elhep/FMC_SDR/IMG/render.png

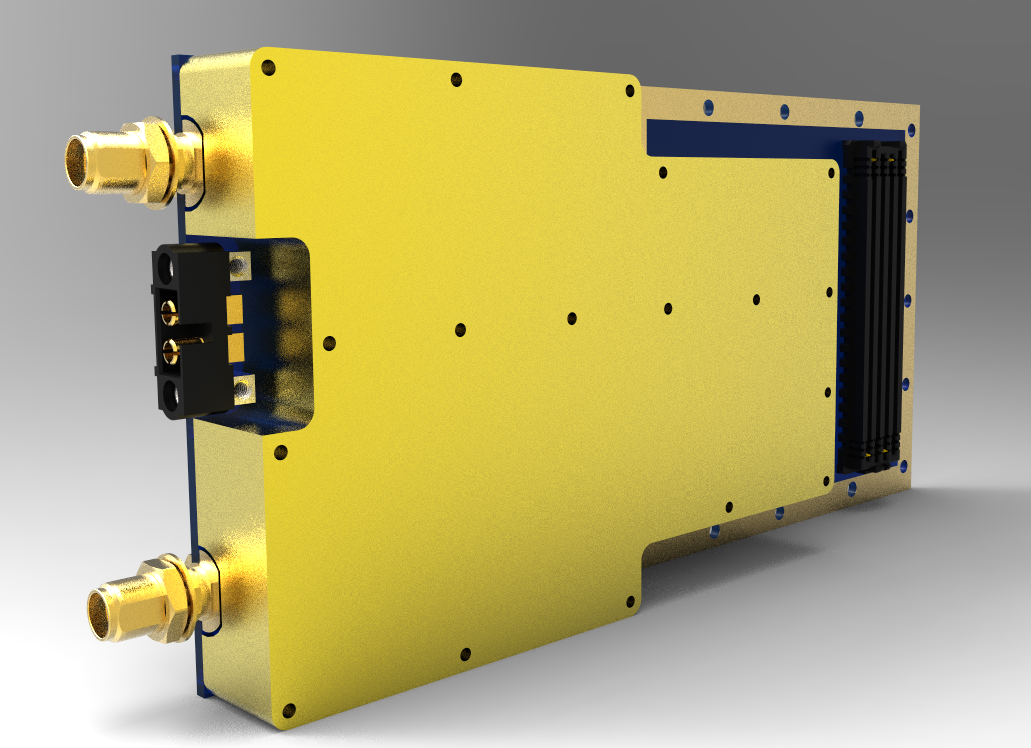
IMG/render.png
