elhep/FMC_SDR/FMC_SDR_LFFE/FMC_SDR_LFFE/31850-200.png

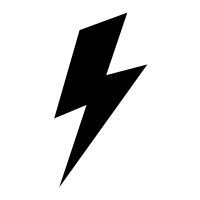
FMC_SDR_LFFE/FMC_SDR_LFFE/31850-200.png
