elhep/FMC_SDR/FMC_SDR/FMC_SDR/Project Outputs for FMC_SDR/BOM/Bill of Materials-FMC_SDR.xls

Author | Manufacturer | Manufacturer Part Number | Manufacturer_Part_Number | Comment | Description | Designator | Footprint | Quantity
CERN DEM JMW |  |  |  | Plated Hole | Single Terminal Socket | B19, B23, B24, B25 | MTG270_500 | 4
 |  |  |  | 0603 Female |  | BSC1, BSC2, BSC3, BSC4, BSC5, BSC7, BSC8, BSC9, BSC10, BSC11, BSC12, BSC13, BSC14, BSC15, BSC16, BSC17, BSC20, BSC21 | PCB_CONN_0603F | 18
 |  |  |  | 1206 Female |  | BSC18, BSC19 | PCB_CONN_1206F | 2
CERN DEM JLC | GENERIC | CC0402_100NF_16V_10%_X7R |  | 100nF | Non-polarised capacitor | C1, C3, C15, C25, C29, C31, C37, C40, C42, C44, C45, C48, C49, C50, C53, C55, C56, C59, C60, C61, C62, C72, C75, C76, C77, C78 | CAPC1005X55N | 26
CERN DEM JLC | GENERIC | CC0402_1UF_16V_10%_X5R |  | 1uF | Non-polarised capacitor | C2, C11, C27, C33, C35, C36, C63, C66, C68, C70, C79, C82, C86, C88, C94, C95 | CAPC1005X55N | 16
CERN DEM JLC | GENERIC | CC0603_10uF_6.3V_20%_X5R |  | 10uF | Non-polarised capacitor | C4, C6, C28, C30, C38, C41, C57, C58, C73, C74 | CAPC1608X87N | 10
CERN DEM JLC | GENERIC | CC0402_1NF_50V_10%_X7R |  | 1nF | Non-polarised capacitor | C5, C8, C17, C19, C21, C22, C23, C84, C92, C101, C130, C133, C136, C139, C142, C145, C148, C151, C154, C160, C198, C204, C206, C208, C210, C212, C214, C215, C216, C217 | CAPC1005X55N | 30
CERN DEM JLC | GENERIC | CC0201_1NF_16V_10%_X5R |  | 1nF | Non-polarised capacitor | C7, C12 | CAPC0603X33N | 2
CERN DEM JLC | GENERIC | CC0402_100PF_50V_5%_C0G |  | 100pF | Non-polarised capacitor | C9, C13, C85, C99, C102, C125, C126, C131, C134, C137, C140, C143, C146, C149, C152, C155, C158, C199, C205, C207, C209, C211, C213 | CAPC1005X55N | 23
CERN DEM JLC | GENERIC | CC0603_1uF_16V_10%_X7R |  | 1uF | Non-polarised capacitor | C10 | CAPC1608X87N | 1
CERN DEM JLC | GENERIC | CC1206_1UF_50V_10%_X7R |  | 1uF | Non-polarised capacitor | C14, C16, C20, C132, C138, C144, C147, C150, C153, C156, C162 | CAPC3216X140N | 11
CERN DEM JLC | GENERIC | CC0603_10UF_10V_10%_X5R |  | 10uF | Non-polarised capacitor | C18 | CAPC1608X80N | 1
CERN DEM JLC | GENERIC | CC0402_10NF_16V_10%_X7R |  | 10nF | Non-polarised capacitor | C24, C32, C65, C81 | CAPC1005X55N | 4
CERN DEM JLC | GENERIC | CC0201_10NF_10V_10%_X5R |  | 10nF | Non-polarised capacitor | C26, C34, C64, C69, C71, C80, C83, C87, C89, C91, C96, C97, C98 | CAPC0603X33N | 13
CERN DEM JLC | GENERIC | CTE3216-18_2.2UF_25V_10% |  | 2.2uF | Polarised capacitor | C39, C52 | CAPMP3216X180N | 2
CERN DEM JLC | GENERIC | CC1206_47UF_25V_20%_X5R |  | 47uF | Non-polarised capacitor | C43, C46, C47 | CAPC3216X180N | 3
CERN DEM JLC | TDK | C3216JB1V226M160AC |  | 22uF | Non-polarised capacitor | C51, C54 | CAPC3216X180N | 2
CERN DEM MR | Undefined | CC0603_NO-VALUE |  | Undefined | Non-polarised capacitor | C93 | CAPC1608X90N | 1
CERN DEM JLC | ANALOG DEVICES | AD7291BCPZ |  | AD7291BCPZ | 8-Channel, I2C, 12-Bit SAR ADC with Temperature Sensor | IC1 | QFN50P400X400X80-21N-S275 | 1
CERN DEM JLC | ST MICROELECTRONICS | M24C02-RDW6TP |  | M24C02-RDW6TP | 2-Kbit (256 x 8bit) Serial I2C Bus EEPROM | IC2 | SOP65P640X120-8N | 1
CERN DEM JLC | MICROCHIP TECHNOLOGIY | MCP9801-M/MS |  | MCP9801-M/MS | 2-Wire High-Accuracy Temperature Sensor | IC3 | SOP65P490X110-8N | 1
 |  |  | ADP2164ACPZ-R7 | ADP2164ACPZ-R7 | 6.5 V, 4 A, High Efficiency,Step-Down,DC-to-DC Regulator | IC4 | CP_16_26 | 1
CERN DEM JLC | ANALOG DEVICES | AD9364BBCZ |  | AD9364BBCZ | RF 1×1 transceiver with integrated 12-bit DACs and ADCs | IC6 | BGA144C80P12X12_1000X1000X170 | 1
CERN DEM JLC | SAMTEC | ASP-134488-01 |  | VITA 57 | Connector VITA 57, 160 Male contacts in 4 row cdgh | J2 | SAMTEC_ASP-127797-01 | 1
CERN DEM JLC | MURATA | BLM15HD102SN1D |  | 1k@100MHz |  | L1 | INDC1005X55N | 1
CERN DEM JMW | COILCRAFT | 0805CS-331XGL |  | 330nH | Inductor With Core | L2, L3 | IND_COILCRAFT_0805CS | 2
CERN DEM JMW | TDK | MMZ1608B601CTAH0 |  | 600R@100MHz |  | L6 | INDC1608X75N | 1
 |  |  |  | 2.2 A, 0.47 uH | WE-MAIA SMD Power Inductor, size 2506, 2.2 A, 0.47 uH | L7, L10 | WE-MAIA_2506 | 2
CERN DEM JLC | TDK | MPZ1608R391A |  | 390R@100MHz |  | L8 | INDC1608X95N | 1
 |  |  |  | 4.7 A, 2.2 uH | WE-MAIA SMD Power Inductor, size 4020, 4.7 A, 2.2 uH | L9 | WE-MAIA_4020 | 1
GK | EPSON | X1E000021036701 |  | 40MHz | 40MHz ±10ppm Crystal 7pF 40 Ohms 4-SMD, No Lead | Q1 | XTAL_EPSON_TSX-3225 | 1
CERN DEM JLC | GENERIC | R0402_10K_1%_0.0625W_100PPM |  | 10k | Resistor - 1% | R1, R5, R6, R8, R22, R26, R29, R30, R33, R34 | RESC1005X40N | 10
CERN DEM JLC | GENERIC | R0402_49R9_1%_0.0625W_100PPM |  | 49R9 | Resistor - 1% | R2, R11, R36 | RESC1005X40N | 3
CERN DEM JLC | GENERIC | R0402_100K_1%_0.0625W_100PPM |  | 100k | Resistor - 1% | R3, R4, R15, R16, R17 | RESC1005X40N | 5
CERN DEM JLC | GENERIC | R0402_1R_1%_0.0625W_200PPM |  | 1 | Resistor - 1% | R7, R9 | RESC1005X40N | 2
CERN DEM JLC | GENERIC | R0603_14K3_0.1%_0.063W_10PPM |  | 14k3 | Resistor - 0.1% | R10 | RESC1608X55N | 1
CERN DEM JLC | GENERIC | R0402_160K_1%_0.0625W_100PPM |  | 160k | Resistor - 1% | R12, R13, R18, R19, R20 | RESC1005X40N | 5
CERN DEM JLC | GENERIC | R0603_10R_1%_0.1W_200PPM |  | 10 | Resistor - 1% | R21, R24 | RESC1608X55N | 2
CERN DEM JLC | Undefined | R0603_NO-VALUE |  | Undefined | Resistor | R23 | RESC1608X55N | 1
CERN DEM JLC | GENERIC | R0402_20K_1%_0.0625W_100PPM |  | 20k | Resistor - 1% | R25 | RESC1005X40N | 1
CERN DEM JLC | GENERIC | R0603_0R_JUMPER |  | 0 | Resistor | R27, R31 | RESC1608X55N | 2
CERN DEM JLC | GENERIC | R0402_16K_1%_0.0625W_100PPM |  | 16k | Resistor - 1% | R28, R32 | RESC1005X40N | 2
CERN DEM JLC | GENERIC | R0402_10R_1%_0.0625W_200PPM |  | 10 | Resistor - 1% | R35 | RESC1005X40N | 1
CERN DEM MR | MINI-CIRCUITS | TCM1-63AX+ |  | 1:1 | 50 Ohms 10 to 6000MHz RF Transformer | TR5, TR6 | XFMR_MINI-CIRCUITS_DB1627 | 2
 | Analog Devices |  |  | ADP1755ACPZ-R7 | 1.2 A, Low VIN, Low Dropout Linear Regulator, 1.6 to 3.6 V Vin, 0.75 to 3 V Vout, Industrial, 16-pin QFN (CP-16-4), Reel | U1, U2 | CP-16-4_L | 2
