elhep/FMC_SDR/FMC_SDR_XFE/FMC_SDR_XFE/Project Outputs for FMC_SDR_XFE/BOM/Bill of Materials-FMC_SDR_XFE.xls

Author | Manufacturer | Manufacturer Part Number | Comment | Description | Designator | Footprint | Quantity
 |  |  | 06031206 Male |  | BSC1, BSC2, BSC3, BSC4, BSC5, BSC6, BSC7, BSC8, BSC10, BSC11, BSC12, BSC13, BSC14, BSC15, BSC16, BSC17, BSC20, BSC21 | PCB_CONN_0603M | 18
 |  |  | 1206 Male |  | BSC18, BSC19 | PCB_CONN_1206M | 2
CERN DEM JLC | GENERIC | CC0402_100PF_50V_5%_C0G | 100pF | Non-polarised capacitor | C1_PreampLO_RX, C1_PreampRX1, C1_PreampRX2, C10_PreampLO_RX, C10_PreampRX1, C10_PreampRX2, C13, C43, C46, C78_PreampLO_TX, C78_PreampTX, C81_PreampLO_TX, C81_PreampTX, C82_PreampLO_TX, C82_PreampTX, C87, C88, C110, C118, C123, C131, C134, C137, C140, C143, C146, C149, C152, C155, C158, C161, C164, C167, C170, C173, C176, C179, C184, C187, C190, C194, C199, C200, C205, C207, C209, C211, C213 | CAPC1005X55N | 48
CERN DEM JLC | GENERIC | CC0402_1NF_50V_10%_X7R | 1nF | Non-polarised capacitor | C2_PreampLO_RX, C2_PreampRX1, C2_PreampRX2, C14, C22, C24, C26, C28, C29, C44, C79_PreampLO_TX, C79_PreampTX, C130, C133, C136, C139, C142, C145, C148, C151, C154, C160, C163, C166, C169, C172, C175, C178, C181, C186, C189, C193, C196, C198, C204, C206, C208, C210, C212, C214, C215, C216, C217, C218, C219 | CAPC1005X55N | 45
CERN DEM JLC | GENERIC | CC1206_10uF_25V_10%_X7R | 10uF | Non-polarised capacitor | C3_PreampLO_RX, C3_PreampRX1, C3_PreampRX2, C80_PreampLO_TX, C80_PreampTX | CAPC3216X180N | 5
CERN DEM MR | GENERIC | CC1206_2.2uF_50V_10%_X7R | 2.2uF | Non-polarised capacitor | C4, C5, C6, C7 | CAPC3216X180N | 4
CERN DEM MR | Undefined | CC0603_NO-VALUE | Undefined | Non-polarised capacitor | C8, C9 | CAPC1608X90N | 2
CERN DEM JLC, CERN DEM JMW | GENERIC | CC0603_1UF_25V_10%_X7R, CC0603_1UF_50V_10%_X5R | 1uF | Non-polarised capacitor | C11, C17, C20, C48, C72, C75, C85, C86, C182, C192 | CAPC1608X87N | 10
CERN DEM JLC | TDK | CKG57NX7S1E476M500JH | 47uF | Non-polarised capacitor | C12 | CAPC_TDK_CKG57N | 1
CERN DEM JLC | GENERIC | CC0603_10NF_50V_5%_C0G | 10nF | Non-polarised capacitor | C15, C16, C19 | CAPC1608X87N | 3
CERN DEM JLC | GENERIC | CC0805_10UF_25V_10%_X5R | 10uF | Non-polarised capacitor | C18, C21, C40_BUCK_3V8, C40_BUCK_5V5, C42, C68, C70, C73, C76, C91, C93, C183 | CAPC2012X95N | 12
CERN DEM JLC | GENERIC | CC1206_1UF_50V_10%_X7R, CC1206_1UF_25V_10%_X7R | 1uF | Non-polarised capacitor | C23, C25, C27, C51, C57, C60, C95, C98, C113, C132, C138, C144, C147, C150, C153, C156, C162, C165, C168, C171, C174, C177, C180, C185 | CAPC3216X140N | 24
CERN DEM JLC, CERN DEM MR | GENERIC | CC0402_100NF_16V_10%_X7R, CC0402_100NF_50V_10%_X7R | 100nF | Non-polarised capacitor | C30, C31, C33, C34, C111, C115, C116, C119, C121, C122, C124, C201, C202, C203 | CAPC1005X55N | 14
CERN DEM JLC | GENERIC | CC0805_10UF_10V_10%_X7R | 10uF | Non-polarised capacitor | C32, C35 | CAPC2012X135N | 2
CERN DEM MR | GENERIC | CC0402_10NF_50V_10%_X7R | 10nF | Non-polarised capacitor | C36, C47, C49, C69, C71, C74, C77 | CAPC1005X55N | 7
CERN DEM JLC | Undefined | CC0402_NO-VALUE | Undefined | Non-polarised capacitor | C37, C45 | CAPC1005X55N | 2
CERN DEM JLC | TAIYO YUDEN, GENERIC | UMK105CG100DVHF, CC0402_10PF_50V_5%_C0G | 10pF | Non-polarised capacitor | C38, C52, C54, C55, C56, C58, C59, C63, C64, C65, C112, C114, C120 | CAPC1005X55N | 13
CERN DEM JLC | GENERIC | CC0805_1UF_50V_10%_X7R | 1uF | Non-polarised capacitor | C39_BUCK_3V8, C39_BUCK_5V5, C41, C90, C92 | CAPC2012X110N | 5
CERN DEM JLC | GENERIC | CC0805_2.2UF_50V_10%_X7R | 2.2uF | Non-polarised capacitor | C50, C53 | CAPC2012X140N | 2
CERN DEM JLC | TAIYO YUDEN | UMK325AB7106KMHP | 10uF | Non-polarised capacitor | C83, C84 | CAPC3225X280N | 2
CERN DEM JLC | GENERIC | CC0805_33NF_25V_10%_X7R | 33nF | Non-polarised capacitor | C109 | CAPC2012X135N | 1
CERN DEM JLC | GENERIC | CC0805_6.8NF_50V_10%_X7R | 6.8nF | Non-polarised capacitor | C117 | CAPC2012X135N | 1
CERN DEM JLC | INFINEON | BAT165 | BAT165 | Schottky Diode | D1, D2 | SOD2512X110N | 2
CERN DEM JLC | MINI-CIRCUITS | LFCN-123+ | DC to 12000MHz | 50 Ohm DC to 12000MHz Low Pass Filter | FL1, FL2 | FIL_MINI-CIRCUITS_FV1206-4 | 2
SH based on CERN | MINI-CIRCUITS | HFCN-7150+ | 7900 to 11000 MHz | 50 Ohm 7900 to 11000 MHz Bandpass Filter | FL3 | FIL_MINI-CIRCUITS_FV1206-1 | 1
SH based on CERN | MINI-CIRCUITS | HFCN-4400+ | 5000 to 10100 MHz | 50 Ohm 5000 to 10100 MHz Bandpass Filter | FL4 | FIL_MINI-CIRCUITS_FV1206-1 | 1
CERN DEM MR | MINI-CIRCUITS | LFCN-2400+ | DC to 2400MHz | 50 Ohm DC to 2400MHz Low Pass Filter | FL5 | FIL_MINI-CIRCUITS_FV1206 | 1
CERN DEM MR | MINI-CIRCUITS | BFCN-8350+ | 8250 to 8450MHz | 50 Ohm 8250 to 8450MHz Band Pass Filter | FL6 | FIL_MINI-CIRCUITS_FV1206-4 | 1
CERN DEM JLC | MINI-CIRCUITS | LEE-39+ | LEE-39+ | Monolithic Amplifier | IC1_PreampLO_RX, IC1_PreampRX1, IC1_PreampRX2, IC23_PreampLO_TX, IC23_PreampTX | MINI-CIRCUITS_FG873 | 5
CERN DEM JLC | LINEAR TECHNOLOGY | LTM8056IY#PBF | LTM8056IY#PBF | 58VIN, 48VOUT Buck-Boost µModule Regulator | IC2 | BGA121C127P11X11_1500X1500X512 | 1
CERN DEM JLC | LINEAR TECHNOLOGY | LTM8074IY#PBF | LTM8074IY#PBF | 40VIN, 1.2A Silent Switcher µModule Regulator | IC3_BUCK_3V8, IC3_BUCK_5V5, IC13, IC24, IC25 | BGA25C65P5X5_400X400X198 | 5
CERN DEM MR | LINEAR TECHNOLOGY | LT1964ES5-BYP#TRMPBF | LT1964ES5-BYP#TRMPBF | 200mA, Low Noise, Low Dropout Negative Micropower Regulator | IC4, IC11, IC12 | SOT95P280X100-5N | 3
CERN DEM JLC | LINEAR TECHNOLOGY | LT1763CS8#PBF | LT1763CS8#PBF | 1.22V to 20V 500mA, Low Noise, LDO Adjustable Micropower Regulator | IC5, IC10, IC17, IC19 | SOIC127P600X175-8N | 4
CERN DEM JLC | MINI-CIRCUITS | SIM-153+ | SIM-153+ | Level 7 (LO Power +7 dBm) 3400 to 15000 MHz | IC6, IC7 | MINI-CIRCUITS_HV1195 | 2
CERN DEM JLC | MINI-CIRCUITS | YAT-3+ | YAT-3+ | DC to 18GHz, 2W, 50 Ohm, 4dB Attenuator | IC8, IC16 | MINI-CIRCUITS_MC1630 | 2
CERN DEM JLC | TEXAS INSTRUMENTS | CDCLVC1102PW | CDCLVC1102PW | 3.3 V and 2.5 V LVCMOS 1:2 High-Performance Clock Buffer | IC9 | SOP65P640X120-8N | 1
CERN DEM JLC | LINEAR TECHNOLOGY | LTC2851CMS8#PBF | LTC2851CMS8#PBF | 3.3V 20Mbps RS485/RS422 Transceivers | IC14, IC18 | SOP65P490X110-8N | 2
SH based on CERN | MINI-CIRCUITS | QCS-83+ | QCS-83+ | 2 Way-90° Power Splitter,50Ω 4000 to 8000 MHz | IC15 | MINI-CIRCUITS_GE0805C-1 | 1
CERN DEM JLC | QORVO | QPA2609 | QPA2609 | 7-14GHz GaAs Low Noise Amplifier | IC20 | QORVO_QPA2609 | 1
CERN DEM JLC | QORVO | TGA3042-SM | TGA3042-SM | 7-10.5GHz 4.5W GaN Power Amplifier | IC21 | QORVO_TGA3042-SM | 1
CERN DEM JLC | TEXAS INSTRUMENTS | INA105KU | INA105KU | Precision, Unity-Gain Differential Amplifier | IC22 | SOIC127P600X175-8N | 1
CERN DEM JLC | LINEAR TECHNOLOGY | LT3080EDD#PBF | LT3080EDD#PBF | Adjustable 1.1A Single Resistor Low Dropout Regulator | IC26 | SON50P300X300X80-9N-R175X248 | 1
CERN DEM JLC | TELEGARTNER | J01151A0451 | SMA |  | J1, J3 | TELEGARTNER_J01151A0451 | 2
CERN DEM JMW | ROSENBERGER | 19S103-400L5 | Coax_1Male_1Shield |  | J2, J6 | ROSENBERGER_19S103-400L5 | 2
CERN DEM JLC | HIROSE (HRS) | U.FL-R-SMT-1(10) | U.FL |  | J4, J7, J8, J9, J10, J11, J13, J14 | HIROSE_U.FL-R-SMT-1(10) | 8
 | Harwin | M80-5000000M5-02-333-00-000 | M80-5000000M5-02-333-00-000 | 2pin (2 power), THT socket with M2 jackscrews | J5 | M80-5000000M5-02-333-00-000 | 1
CERN DEM MR | SAMTEC | HW-04-15-L-S-400-150 | Header 4 | Connector 4 Male | J12 | SAMTEC_HW-04-15-L-S-400-150 | 1
CERN DEM JLC | MINI-CIRCUITS | TCCH-80+ | 0.5uH@200mA | 50 Ohms, 50 to 8200 MHz RF Choke | L1_PreampLO_RX, L1_PreampRX1, L1_PreampRX2, L4_PreampLO_TX, L4_PreampTX | IND_MINI-CIRCUITS_GU1604 | 5
CERN DEM JLC | COILCRAFT | 0402DC-15NXGRW | 15nH | Inductor With Core | L2, L3 | IND_COILCRAFT_0402DC | 2
CERN DEM MR | KYOCERA | KT7050A20000KAW33TAD | 20MHZ | Oscillator KYOCERA | OSC1 | OSC_KYOCERA_KT7050A | 1
CERN DEM JLC | BOURNS | 3223W-1-503E | 50k | Trimming Potentiometer | P1, P2, P3 | TRIM_BOURNS_3223W | 3
CERN DEM JLC | GENERIC | R0402_0R_JUMPER | 0 | Resistor | R1, R8, R9, R36, R44, R65, R66, R67, R69, R72, R107 | RESC1005X40N | 11
CERN DEM JLC | Undefined | R0402_NO-VALUE | Undefined | Resistor | R2, R3, R4, R5, R6, R7, R25, R54, R55, R64, R68, R104, R106, R116 | RESC1005X40N | 14
CERN DEM JLC | Undefined | R1206_NO-VALUE | Undefined | Resistor | R10, R38, R81, R108 | RESC3216X65N | 4
CERN DEM JLC | VISHAY | R0805_40K2_1%_0.125W_100PPM | 40k2 | Resistor - 1% | R11, R52 | RESC2012X60N | 2
CERN DEM JLC | GENERIC | R0603_0R_JUMPER | 0 | Resistor | R12, R16, R20, R26, R31, R33, R56, R61, R63, R70, R83, R88, R89, R90, R91, R92, R105, R113, R115, R117_BUCK_3V8, R117_BUCK_5V5, R118, R119, R120, R125, R132, R133, R142 | RESC1608X55N | 28
CERN DEM JLC | GENERIC | R0603_100K_0.1%_0.063W_10PPM | 100k | Resistor - 0.1% | R13 | RESC1608X55N | 1
CERN DEM JLC | GENERIC | R0603_42K2_0.1%_0.063W_10PPM | 42k2 | Resistor - 0.1% | R14 | RESC1608X55N | 1
CERN DEM JLC | GENERIC | R0603_6K19_0.1%_0.063W_10PPM | 6k19 | Resistor - 0.1% | R15 | RESC1608X55N | 1
CERN DEM JLC | Undefined | R0603_NO-VALUE | Undefined | Resistor | R17, R18, R22, R24, R27, R28, R30, R32, R35, R50, R57, R150 | RESC1608X55N | 12
CERN DEM JLC | GENERIC | R0805_62K_1%_0.125W_100PPM | 62k | Resistor - 1% | R19 | RESC2012X60N | 1
CERN DEM JLC | GENERIC | R1206_0R_JUMPER | 0 | Resistor | R21, R37, R80, R82, R95, R98, R112, R114 | RESC3216X65N | 8
CERN DEM JLC | GENERIC | R0402_10K_1%_0.0625W_100PPM | 10k | Resistor - 1% | R23, R29, R34 | RESC1005X40N | 3
CERN DEM JLC | GENERIC | R0603_68R_1%_0.1W_100PPM | 68 | Resistor - 1% | R39 | RESC1608X55N | 1
CERN DEM JLC | GENERIC | R0603_430R_1%_0.1W_100PPM | 430 | Resistor - 1% | R40 | RESC1608X55N | 1
CERN DEM JLC | GENERIC | R0402_27K_1%_0.0625W_100PPM | 27k | Resistor - 1% | R41, R43 | RESC1005X40N | 2
CERN DEM MR | GENERIC | R0402_5R1_1%_0.0625W_100PPM | 5R1 | Resistor - 1% | R42, R46, R47, R48, R49, R53 | RESC1005X40N | 6
CERN DEM JLC | GENERIC | R0402_1M_1%_0.0625W_100PPM | 1M | Resistor - 1% | R45 | RESC1005X40N | 1
CERN DEM JLC | GENERIC | R0603_18K_1%_0.1W_100PPM | 18k | Resistor - 1% | R51_BUCK_3V8, R51_BUCK_5V5, R62, R99, R101 | RESC1608X55N | 5
CERN DEM JLC | GENERIC | R0603_43R_1%_0.1W_100PPM | 43 | Resistor - 1% | R58_PreampLO_RX, R58_PreampRX1, R58_PreampRX2, R59_PreampLO_TX, R59_PreampTX | RESC1608X55N | 5
CERN DEM JLC | GENERIC | R0603_45K3_0.1%_0.063W_10PPM | 45k3 | Resistor - 0.1% | R60, R100 | RESC1608X55N | 2
CERN DEM JLC | GENERIC | R0402_49R9_1%_0.0625W_100PPM | 49R9 | Resistor - 1% | R71, R73, R74, R75 | RESC1005X40N | 4
CERN DEM JLC | GENERIC | R0603_75K_1%_0.1W_100PPM | 75k | Resistor - 1% | R76, R77 | RESC1608X55N | 2
CERN DEM JLC | GENERIC | R0603_2K7_1%_0.1W_100PPM | 2k7 | Resistor - 1% | R78 | RESC1608X55N | 1
CERN DEM JLC | GENERIC | R0603_510R_1%_0.1W_100PPM | 510 | Resistor - 1% | R79 | RESC1608X55N | 1
CERN DEM JLC | GENERIC | R0402_22K_1%_0.0625W_100PPM | 22k | Resistor - 1% | R84, R86 | RESC1005X40N | 2
CERN DEM JLC | GENERIC | R0402_12K_1%_0.0625W_100PPM | 12k | Resistor - 1% | R85, R87, R96, R97 | RESC1005X40N | 4
CERN DEM BC | GENERIC | R0402_38K3_1%_0.0625W_100PPM | 38k3 | Resistor - 1% | R93, R94 | RESC1005X40N | 2
CERN DEM MR | GENERIC | R0402_0.1R_1%_0.0625W_100PPM | 0.1 | Resistor - 1% | R102, R103 | RESC1005X40N | 2
CERN DEM JLC | GENERIC | R0603_49K9_0.1%_0.063W_10PPM | 49k9 | Resistor - 0.1% | R109 | RESC1608X55N | 1
CERN DEM JLC | GENERIC | R0603_499R_0.1%_0.063W_10PPM | 499 | Resistor - 0.1% | R110 | RESC1608X55N | 1
CERN DEM JLC | GENERIC | R0603_1K96_0.1%_0.063W_10PPM | 1k96 | Resistor - 0.1% | R111 | RESC1608X55N | 1
 |  |  | ADF5356 |  | U6 | ADF3356 | 1
