elhep/FMC_SDR/inerCover_11032020.STEP

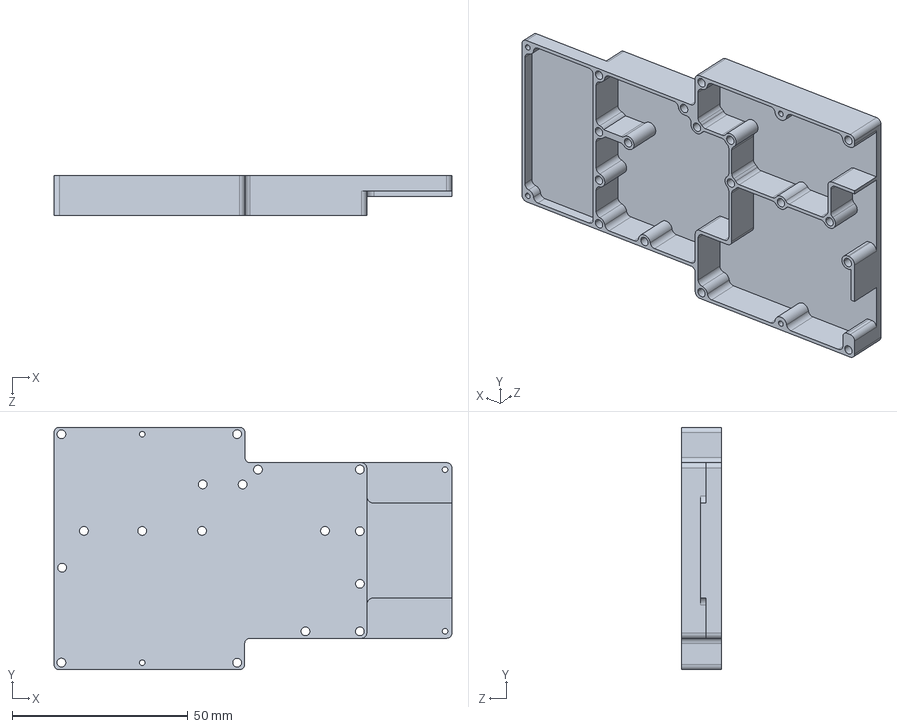
[picture p3: CAD file, 2020-03-18]
inerCover_11032020.STEP
113.3 x 69.0 x 11.5 mm
