elhep/FMC_SDR/(list of files, cad)

Other CAD files:
FMC_SDR/FMC_SDR/PCB-Layout/FMC_SDR.DWG
