elhep/FMC_SDR/(threads)

Thread 3 (2019-11-15):

X-band Rx chain

gkasprow, 2019-11-15:
Consider placing LPF filter after mixer. The LO may leak and saturate the next gain stages.

Thread 7 (2020-03-03):

DRC errors

gkasprow, 2020-03-03:
@shanasz there are some unrouted nets.
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

In case of the errors, just waive them.
Did U perform ERC and DRC?

shanasz, 2020-03-03:
I am now trying to merge new version with Your previous remarks introduced. Give me a while, I have some problem with repo.

shanasz, 2020-03-03:
But Yes, generally in tagged commits I always do ERC and DRC

gkasprow, 2020-03-03:
don't use merge function. It doesn't work with Altium files.

shanasz, 2020-03-03:
ok, design ready for review

Thread 18 (2020-03-19):

FMC_SDR IC6 AD9364

tprzywoz, 2020-03-19:
- [ ] TX/RX_EXT_LO_IN: "When this pin is unused, tie it to ground". Now they are floating (no connection on FMC_SDR_XFE board)

- [ ] RXB_P/N "Unused pins must be tied to ground". Now they are floating.

- [ ] TXB_P/N "Unused pins must be tied to 1.3 V". Now they are floating.

- [ ] There is double connection to FMC of SYNC_IN signal. Is this intentional?

- [ ] RXA / TXA to RF Transformers: For TX signal negative one is connected to Secondary Dot pin, for RX it is positive. Is this intentional? On devkit they keep negative to secondary dot connection for both.

Thread 20 (2020-03-19):

FMC_SDR 50 Ohm Impedance Profile

tprzywoz, 2020-03-19:
There is a configuration for 30 Ohm impedance on layer Int1 and Int5 instead of 50 Ohm.

tprzywoz, 2020-03-19:
And change Min Width value to Preferred Width in Width_50R rule because now some 50R traces on inner layers are 0.12 mm instead of 0.17 mm.

Thread 22 (2020-03-19):

FMC_SDR PCB rules

tprzywoz, 2020-03-19:
Clearance_50R_EXTt - there is no RF_50R ComponentClass
Clearance_50R_INT - there are no 'Int2' and 'Int3' layers
Width_BGA1 - there are no rooms at all on PCB

Thread 23 (2020-03-19):

FMC_SDR PCB review

tprzywoz, 2020-03-19:
1. Copper balance polygon shouldn't be solid plane:
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

2. Teardrops

3. Some unnecessary separations of differential pairs:
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

4. There are no fiducial markers

Thread 24 (2020-03-19):

FMC_SDR_XFE PLL

tprzywoz, 2020-03-19:
- [ ] 'Charge Pump Power Supply. Vp must have the same value as Vvco' - must be changed 3.3 V -> 5 V.

- [ ] Vregvco same as Vp

- [ ] Will we use RFOUTA? Datasheet suggests to terminate unused complementary outputs and now we can terminate only RFOUTA- by mounting C45 and there is no termination for unused RFOUT+.

- [ ] Please place capacitors on PCB according to the schematic. For example, now C112 (connected on schematic to pin 19) is connected to pin 16 on PCB. Pin 19 (Vregvco) should have more capacitors on schematics but has proper configuration on PCB (+ remember about wrong value of power supply for pin 19).

- [ ] REF_IN: R72 or R1 should be DNP

- [ ] Synchronize PLL.SchDoc block on FronEnd schematic - now REF_IN port is input type inside and output type outside.

Thread 25 (2020-03-20):

FMC_SDR_XFE IC20

tprzywoz, 2020-03-20:
- [ ] Vdd is 3.5 V (not 3.3 V, real configuration is 3.46 V) so change Power Net name.

- [ ] It is recommended to connect NC pins (5 7 13 15) to GND

Thread 26 (2020-03-20):

FMC_SDR_XFE Power Supply

tprzywoz, 2020-03-20:
IC18:
- [ ] VCC should be 3.3 V (not 5 V). And it cannot be connected to the line whose activation it potentially controls.

- [ ] check TX_NSHDN_ISO signal. Some power supply ICs have floating RUN/Enable pins which are connected only to this signal by 'Undefined' jumpers.

- [ ] detail: change net labels - TX_NSHDND_N to inverting input output (IC18 and IC14) and TX_NSHDND_P to noninverting IO.  I know it's control signal but maybe add termination resistor.

All LT1763 with 3V3 output:
- [ ] Configuration is 3,5 V, Power Port name is 3.3 V

IC17

- [ ] wrong ADJ configuration (now is 5 V)

IC26

- [ ] wrong SET configuration (now is 2.4 V, should be 20 V)

IC2

- [ ] floating RUN

- [ ] details: add some notes about configurations (RT MODE) and please connect input capacitors the same way as output on schematic.

BUCKBOOST_OUT
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

- [ ] FE_12V can't be an alternative power source for PA_LDO which output should be 20 V.

IC5:

- [ ] wrong ADJ configuration (now is 3.5 V)

IC11

- [ ] detail: double GND power port on pin 1

J5
- [ ] add a note about voltage and current

Rest:
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
I wonder if we should move the input capacitors behind the jumpers.

Please change the power names to the standard convention if possible (like P3V3_description). And don't use '-' for negative voltage. 'N' is much better. Also power symbol for positive supply should point up and those for negative supplies should point down (now most of them on FrontEnd_PS point right)

tprzywoz, 2020-03-20:
And as I wrote in the email to remember: implement bias-up/down procedure for amplifiers.

Thread 27 (2020-03-20):

Schematics cosmetics

tprzywoz, 2020-03-20:
- [ ] Use normal components instead of "undefined". Then configure them as not fitted using variant feature.

- [ ] Add 'CERN Open Hardware Licence' text

**FMC_SDR_XFE**

- [ ] Note says about FL6: "Can be exchanged for HFCN-9700+ or BFCN-5750+ for amateur bands." Add more information about other necessary component replacement because for example, BFCN-5750+ pass band is 5650 - 5850 MHz and next stage amplifier 7-14 GHz.

**FMC_SDR:**
- [ ] Place decoupling capacitors on transceiver sheet (not power supply sheet)

- [ ] fmc_connector.SchDoc - change formatting page template

- [ ] add a note about allowed Vadj levels (fmc connector)

- [ ] Maybe add some test points? I2C SPI

- [ ] We have LA33 pins free so maybe connect some diagnostic lines for example PG

Models:

- [ ] add pin type information (in/out/power) for IC4

- [ ] (XFE board) IC15 is Splitter/Combiner so 1 4 and 6 pins should be I/O. Correct the description (2 Way-90 and different frequencies)

- [ ] So-153+ correct the description

Thread 28 (2020-03-20):

New components

tprzywoz, 2020-03-20:
- [ ] **HFCN-4400+ and HFCN-7150+:**

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

- [ ] **LEE-39+**

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

- [ ] **SIM-153+** - problem with dimension K
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

- [ ] **YAT-3+** - general description 4dB, part description 3db (both should be 3dB)
- [ ] **CDCLVC1102PW** maybe add NC pins (5 & 7) to SCH.

- [ ] **QSC-83+** - problem with dimesnions H and K:
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

Thread 29 (2020-03-20):

PCB RF signals

tprzywoz, 2020-03-20:
- [ ] remember about cutouts in GND polygon under resistors and capacitors pads

- [ ] when you use two jumpers to create an alternative path, place them so that they have a common pad to reduce the impedance discontinuity
