elhep/FMC_SDR/FMC_SDR_XFE/FMC_SDR_XFE/Project Outputs for FMC_SDR_XFE/Schematic Print/FMC_SDR_XFE_SCH.PDF

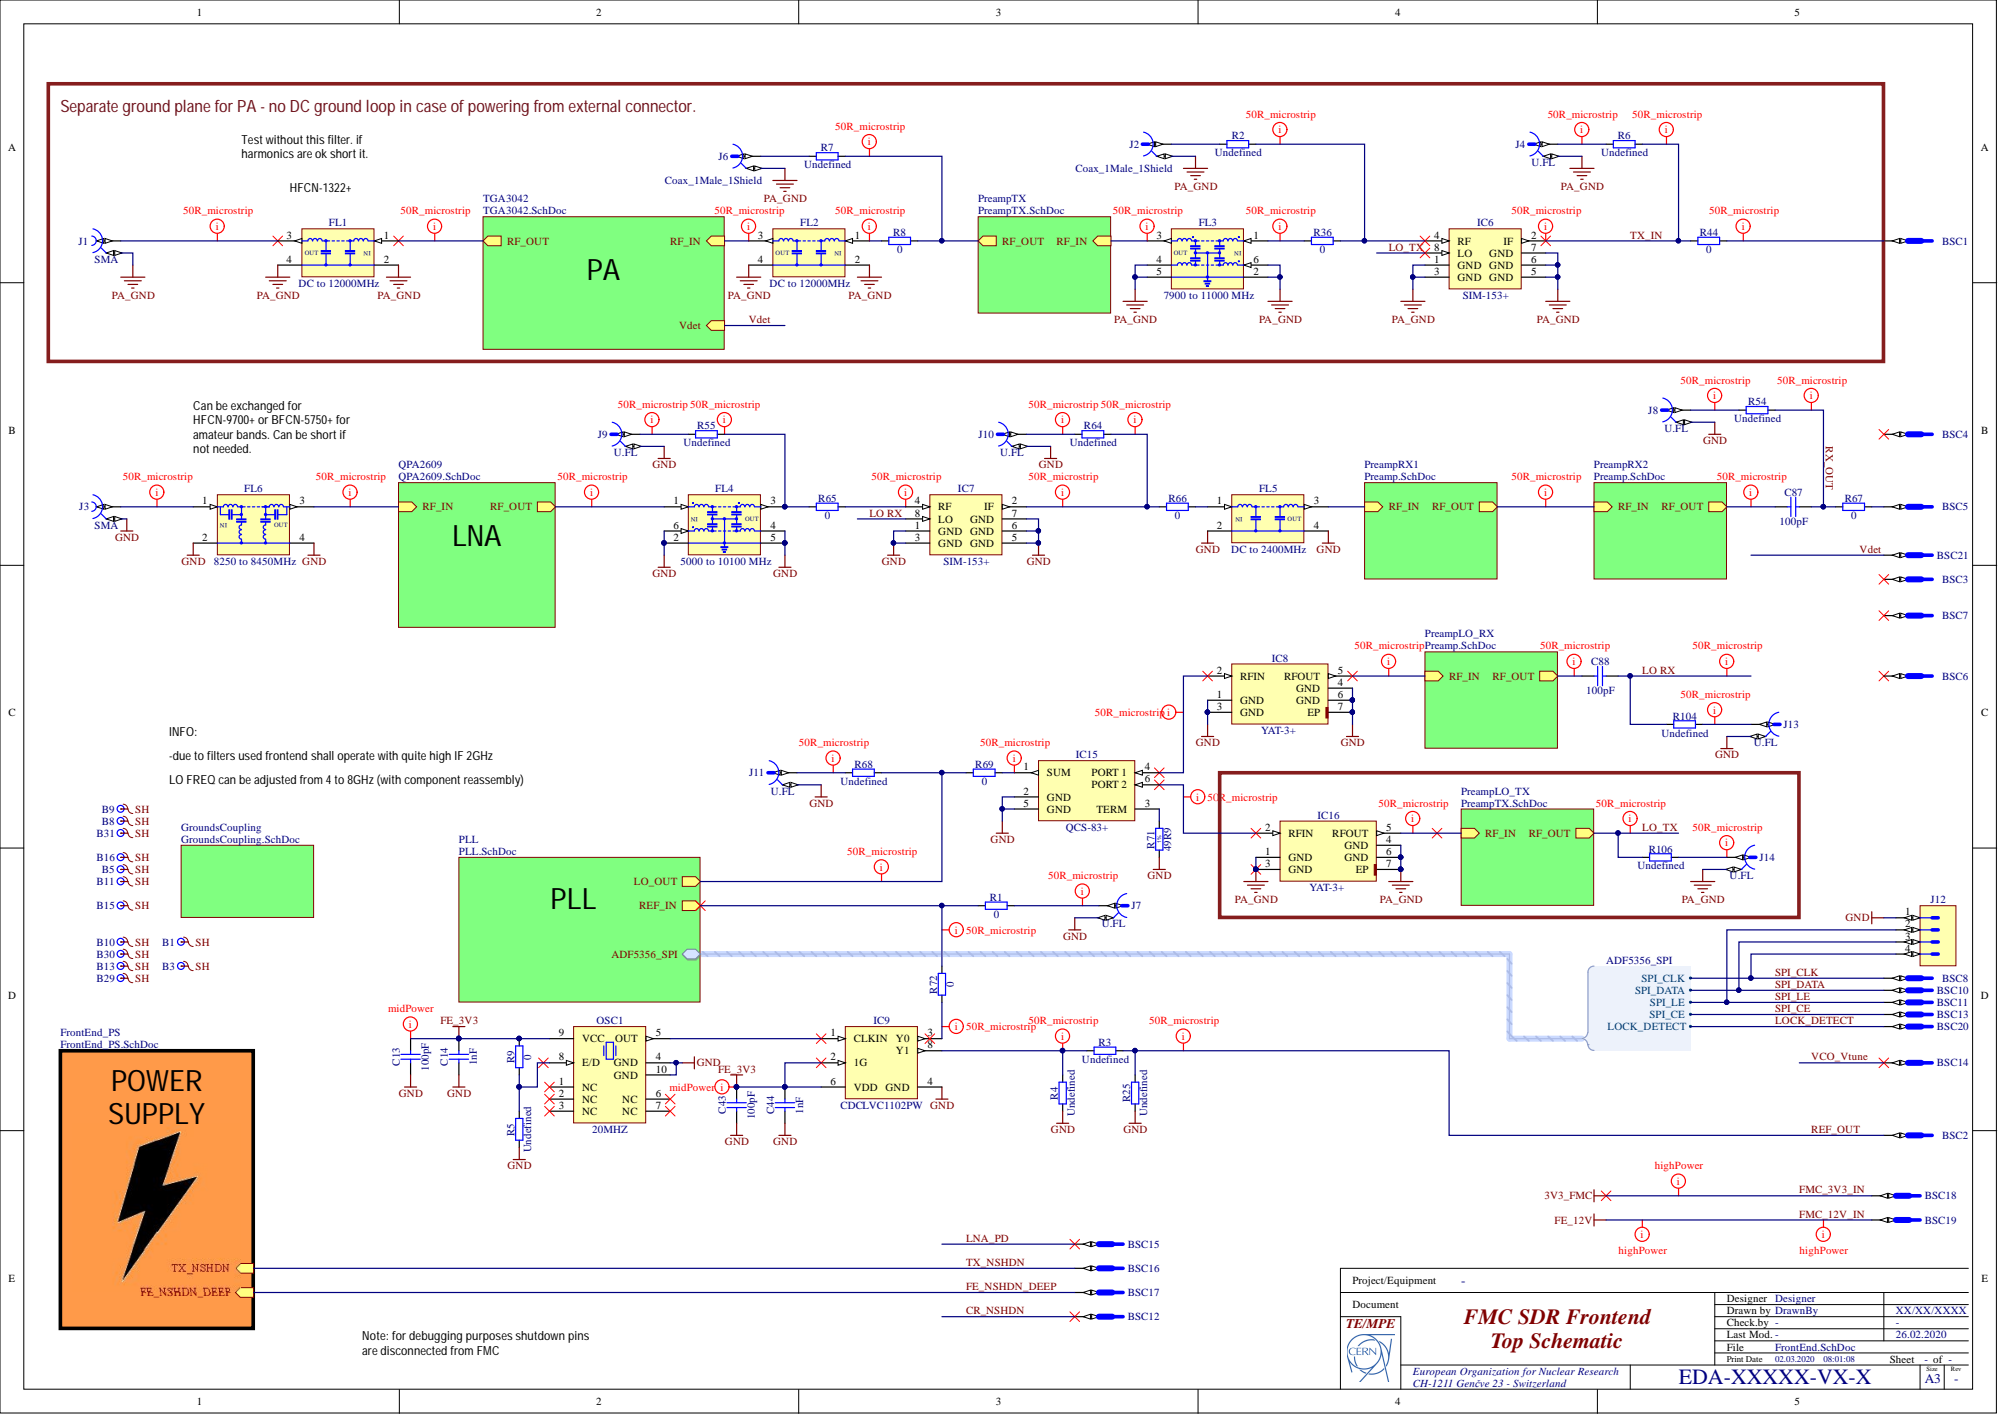
[picture p4: page 1]

Separate ground plane for PA - no DC ground loop in case of powering from external connector.

Test without this filter. if
harmonics are ok short it.

Can be exchanged for
HFCN-9700+ or BFCN-5750+ for
amateur bands. Can be short if
not needed.

-due to filters used frontend shall operate with quite high IF 2GHz

LO FREQ can be adjusted from 4 to 8GHz (with component reassembly)

Note: for debugging purposes shutdown pins
are disconnected from FMC

European Organization for Nuclear Research
CH-1211 Genčve 23 - Switzerland

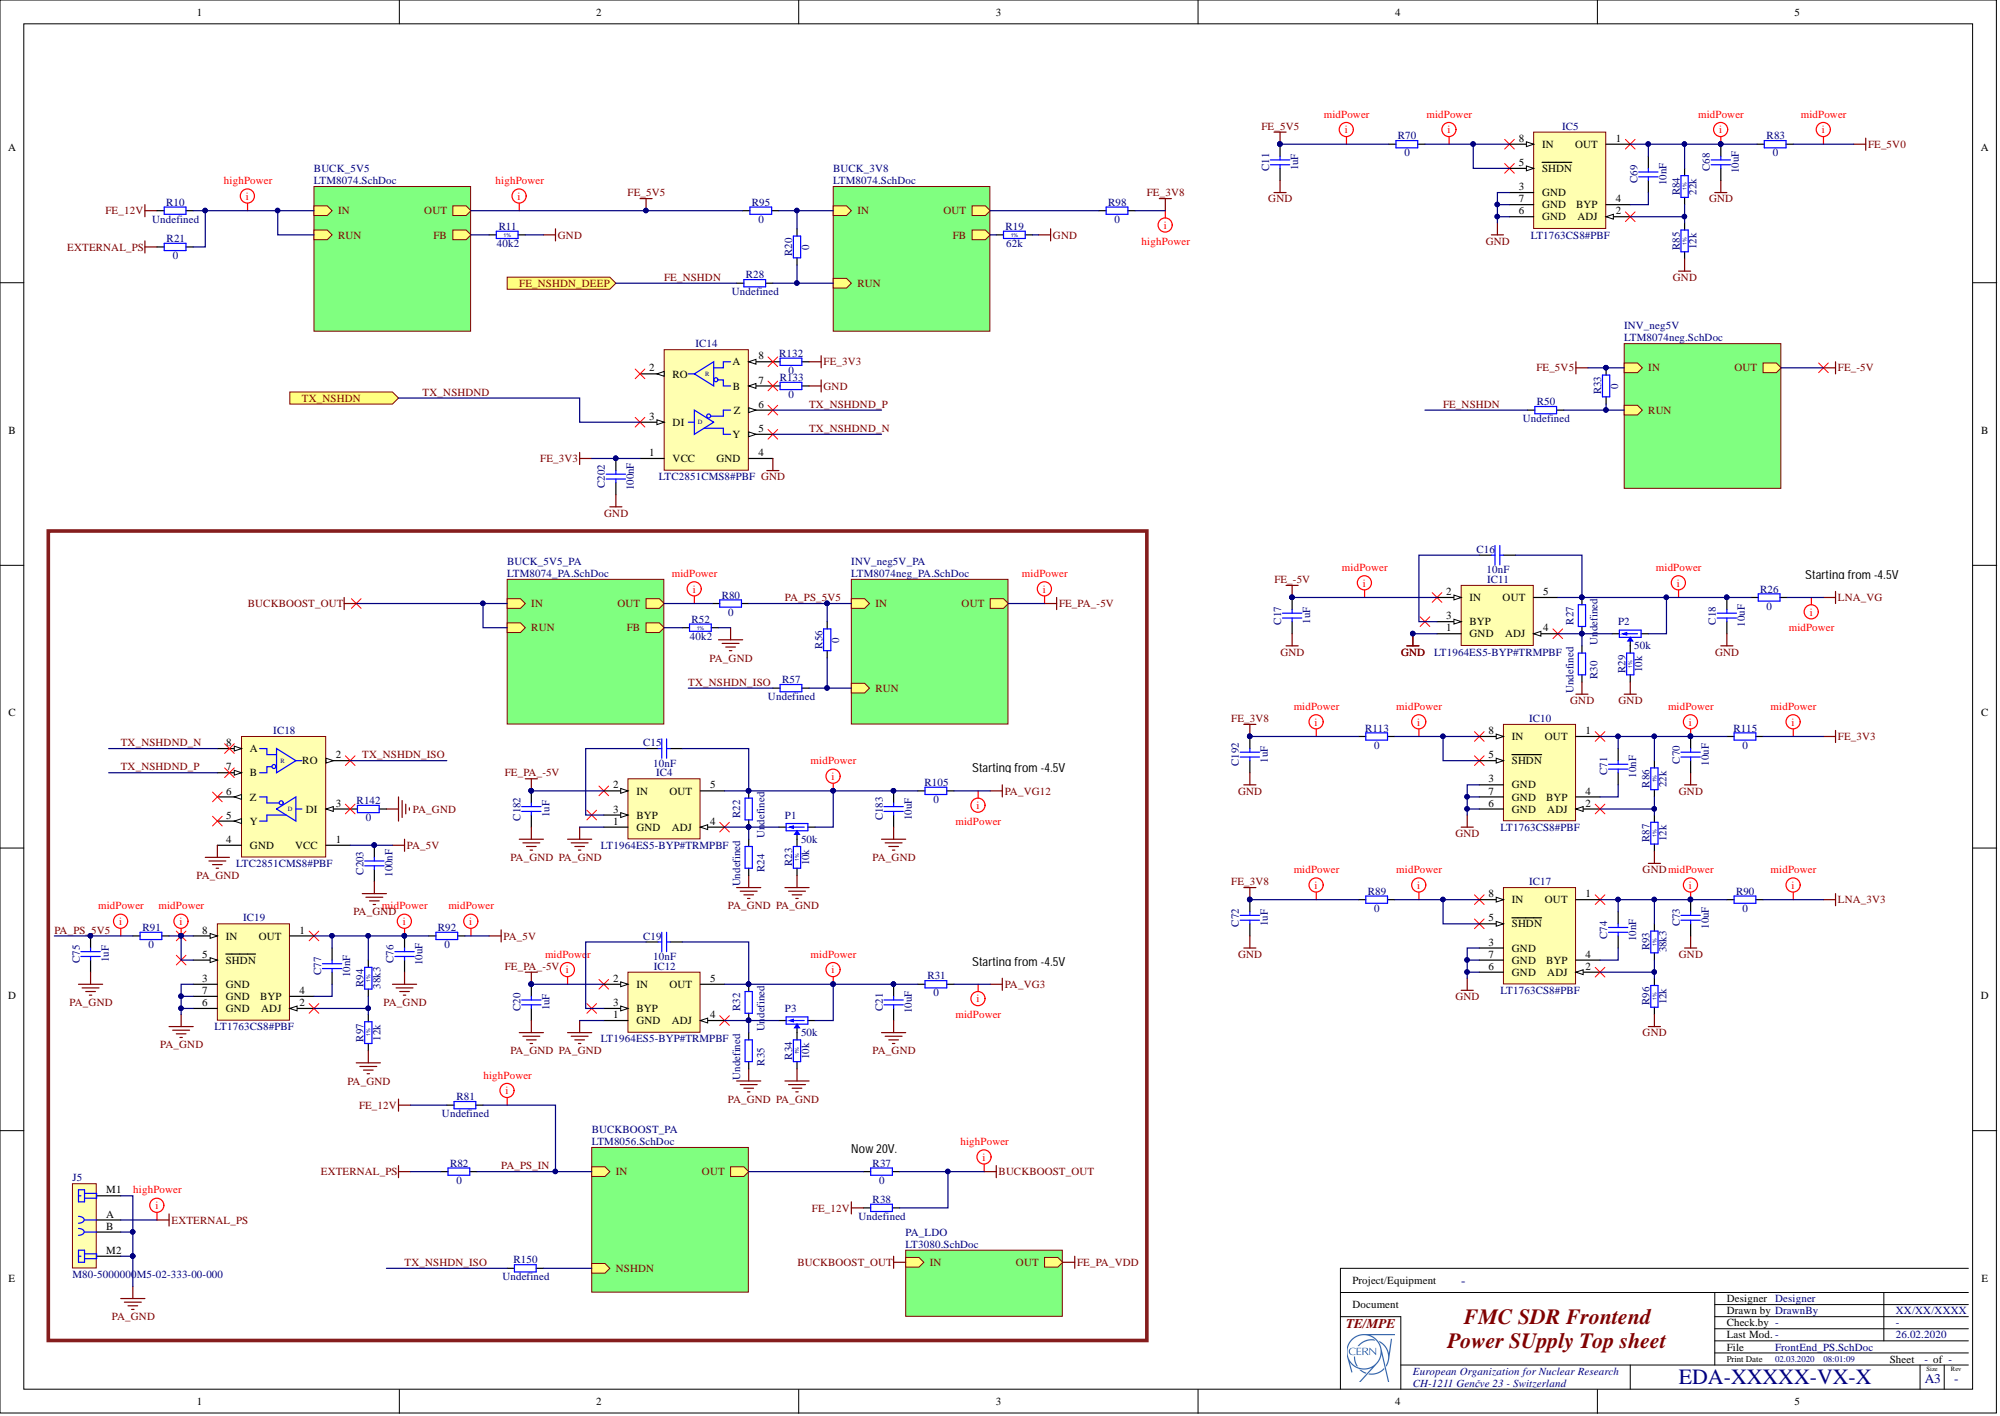
[picture p5: page 2]

Power SUpply Top sheet

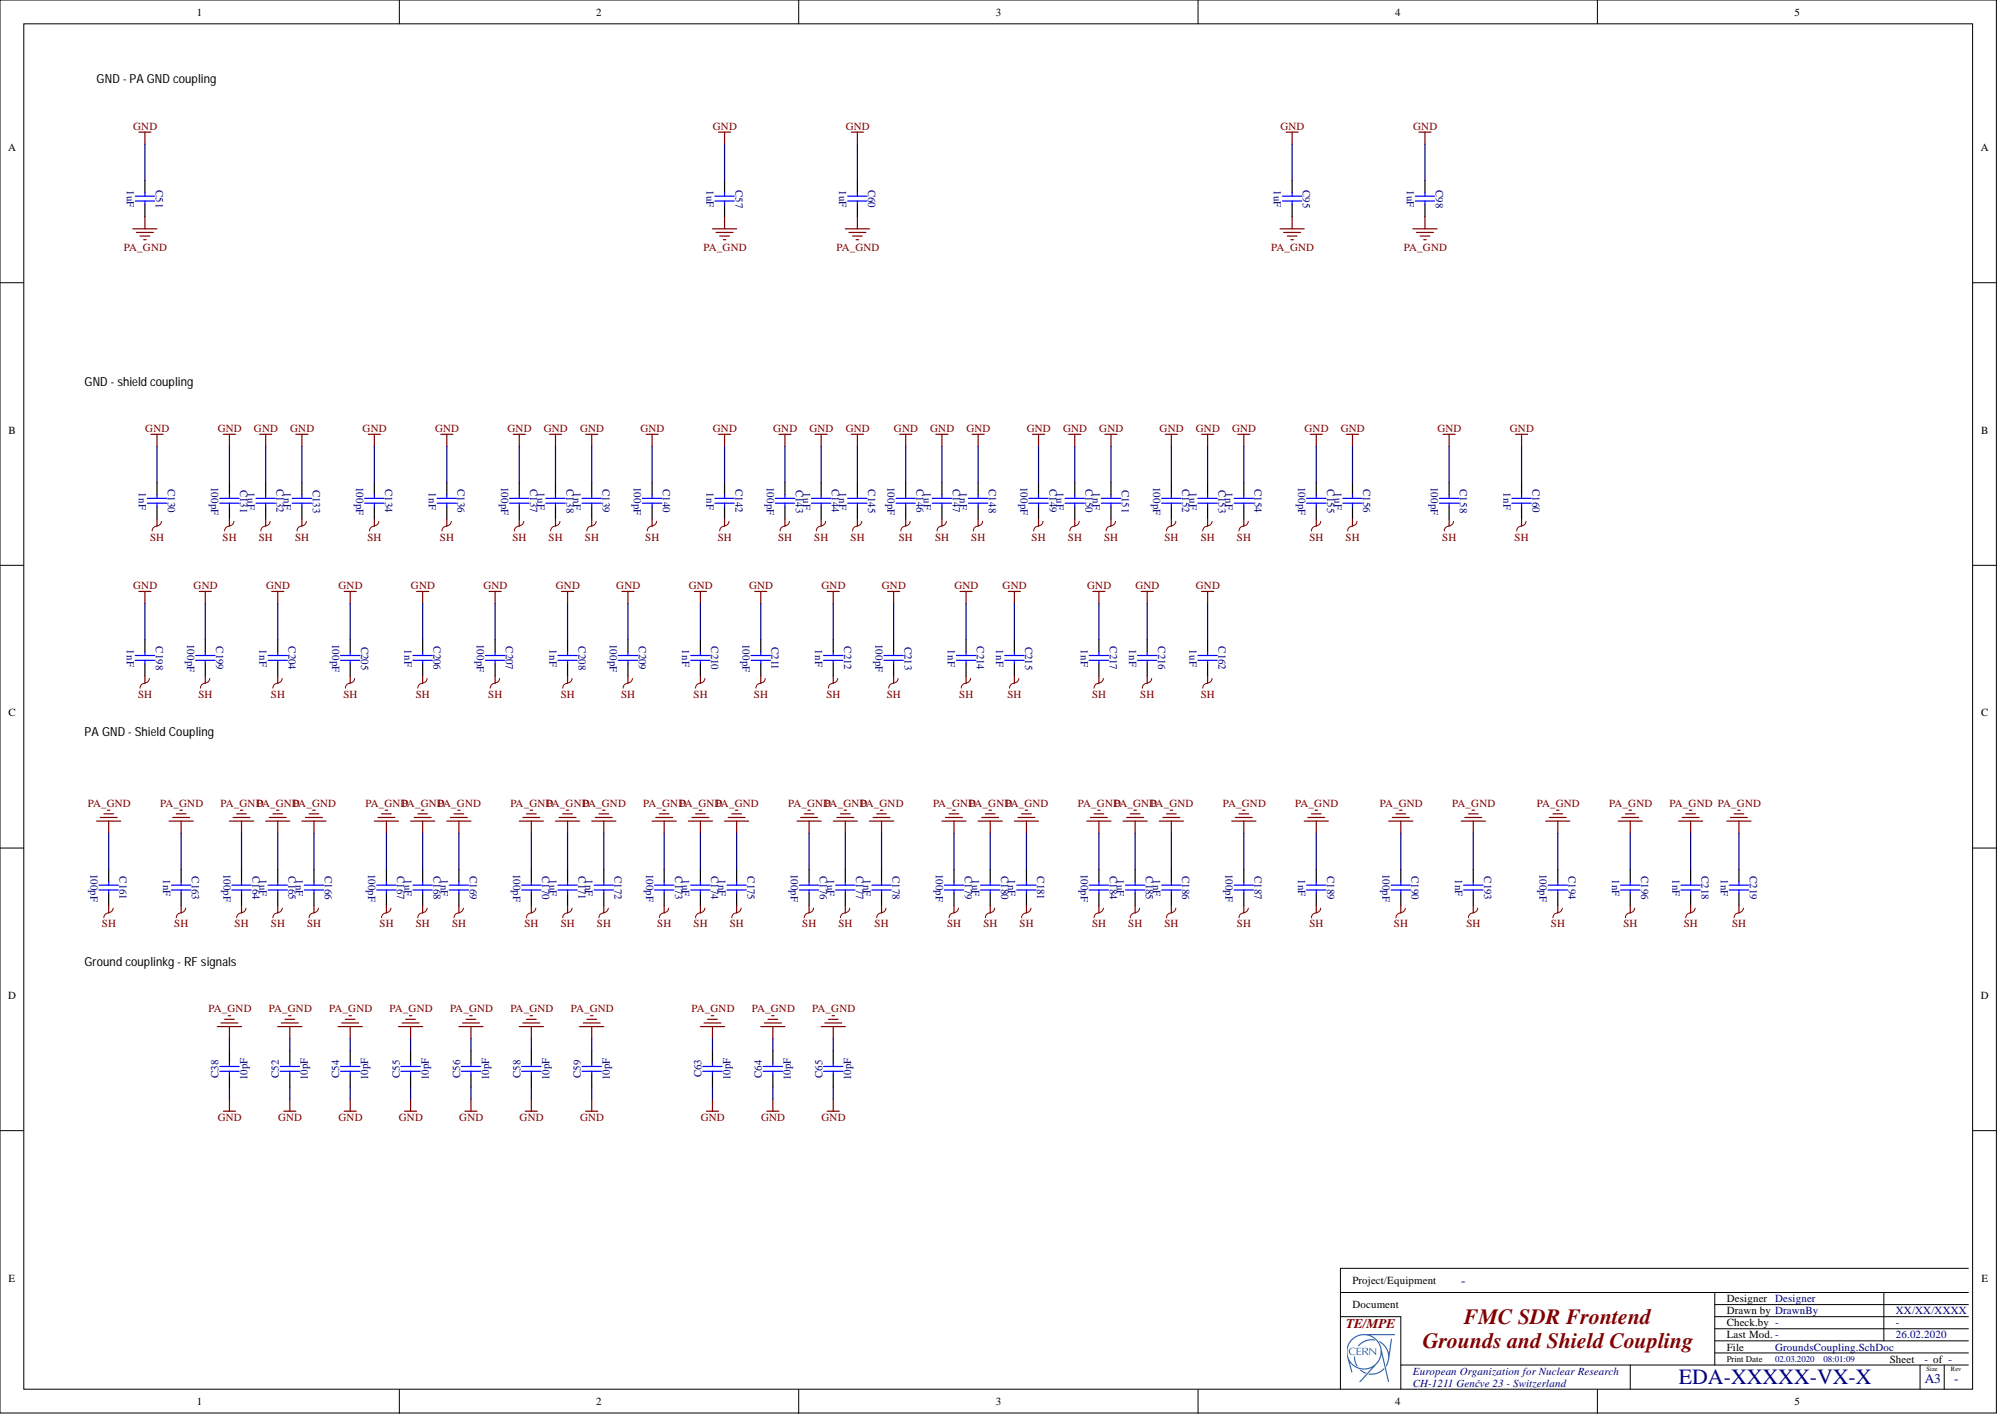
[picture p6: page 3]

GND - PA GND coupling

PA GND - Shield Coupling

Ground couplinkg - RF signals

Grounds and Shield Coupling

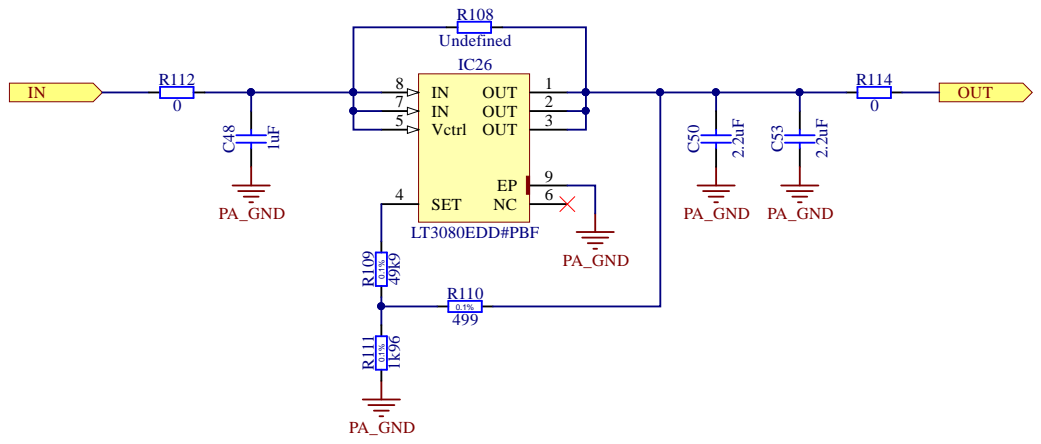
[picture p7: page 4]

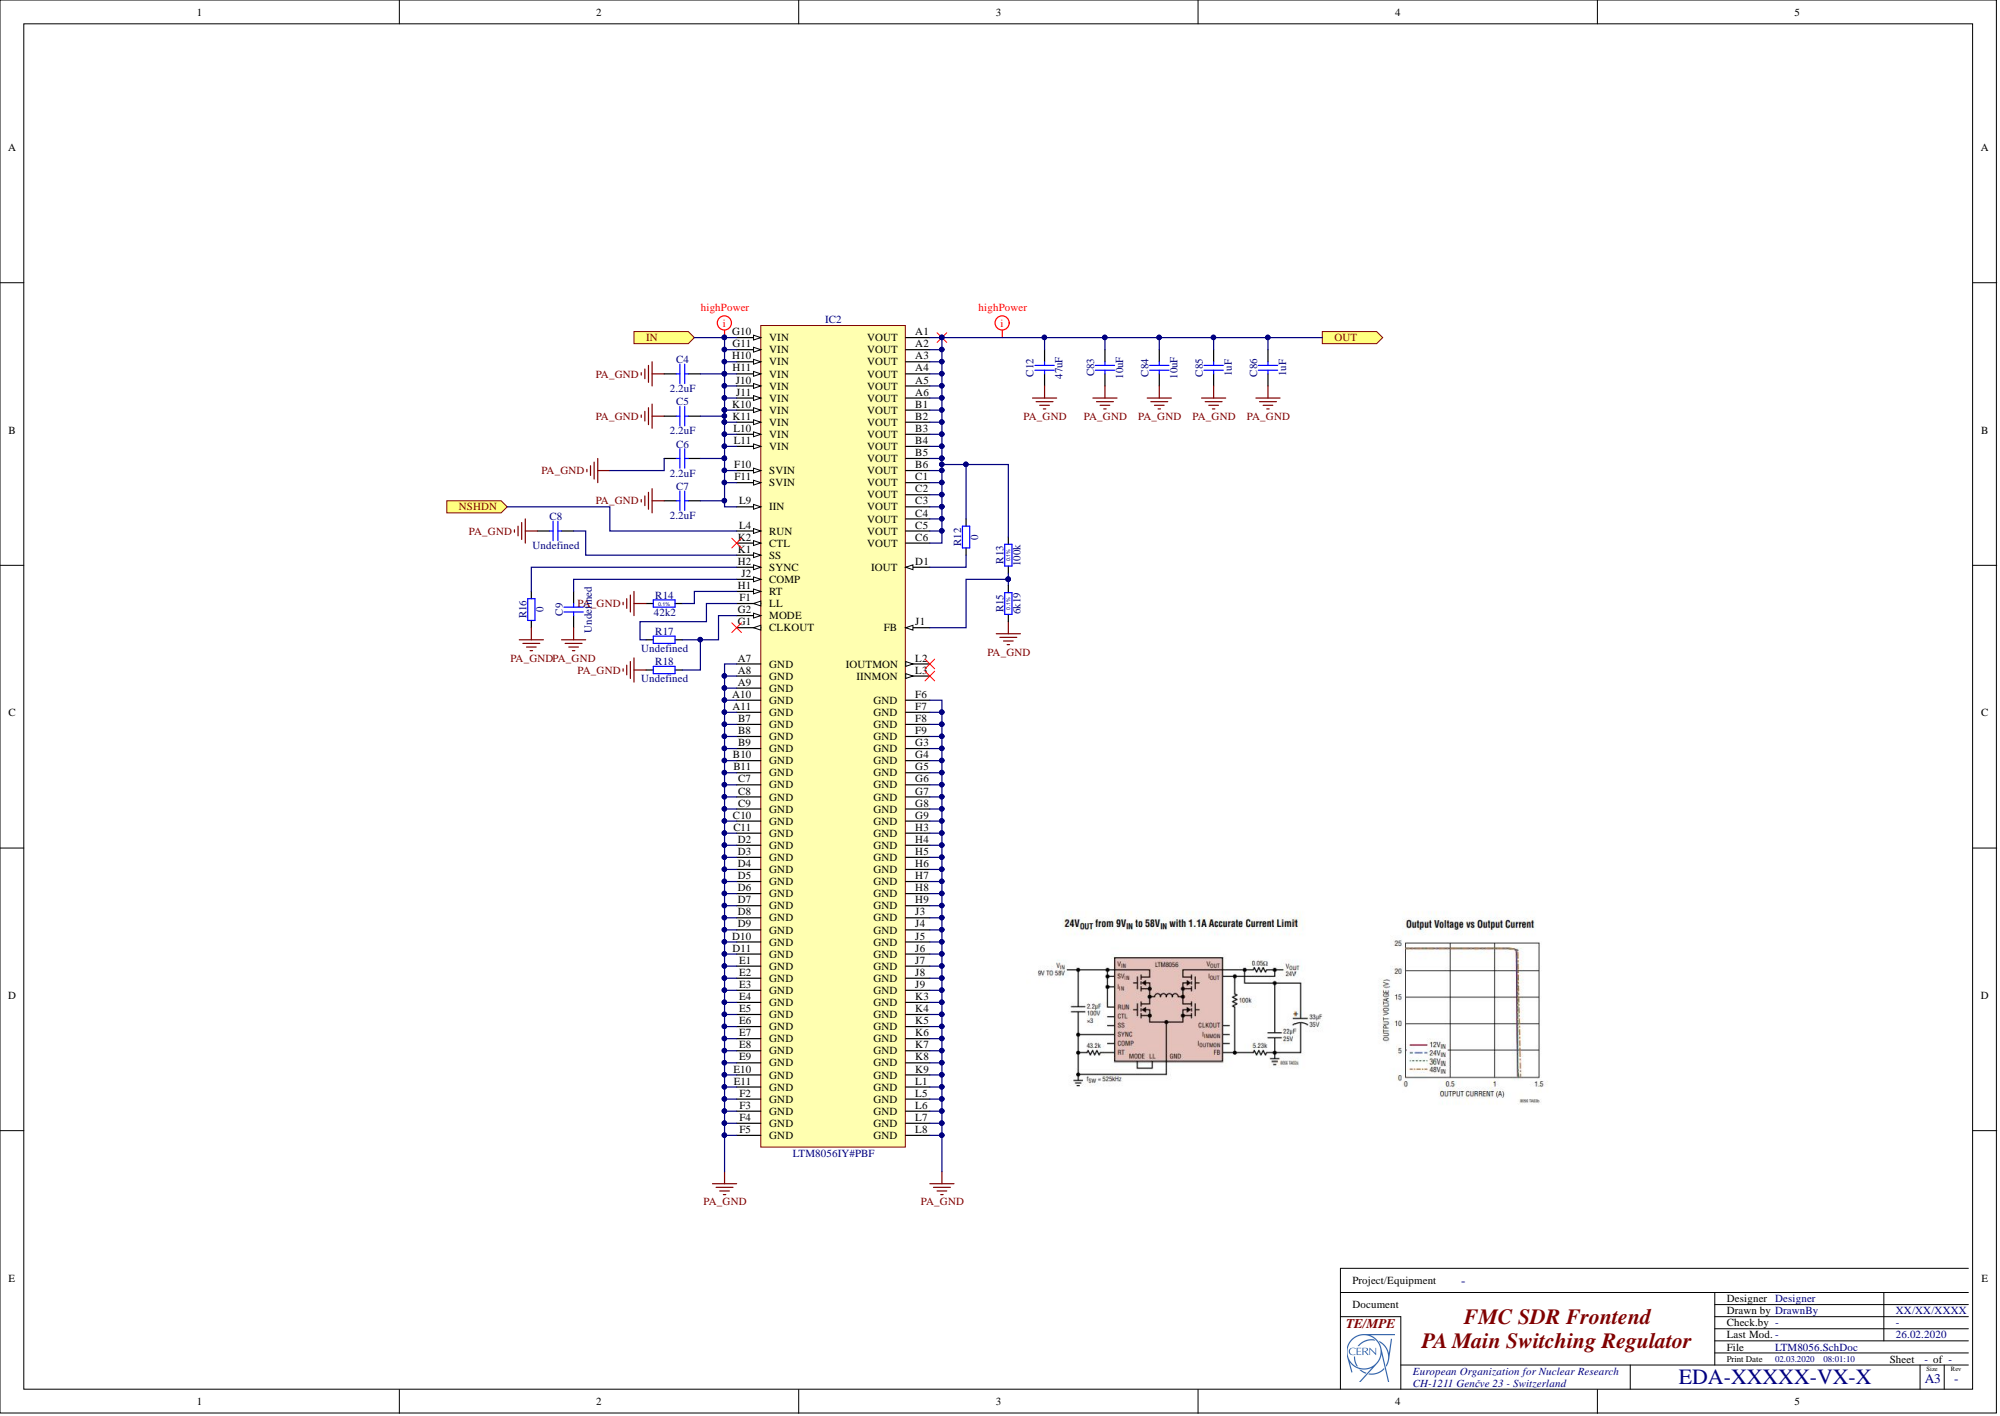
[picture p8: page 5]

VIN L10

SVIN F10

2.2uF | RUN L4

SS K1 CTL K2

COMP J2
RT H1

R14 | | LL F1
0.1% | | CLKOUT G1 MODE G2

PA Main Switching Regulator

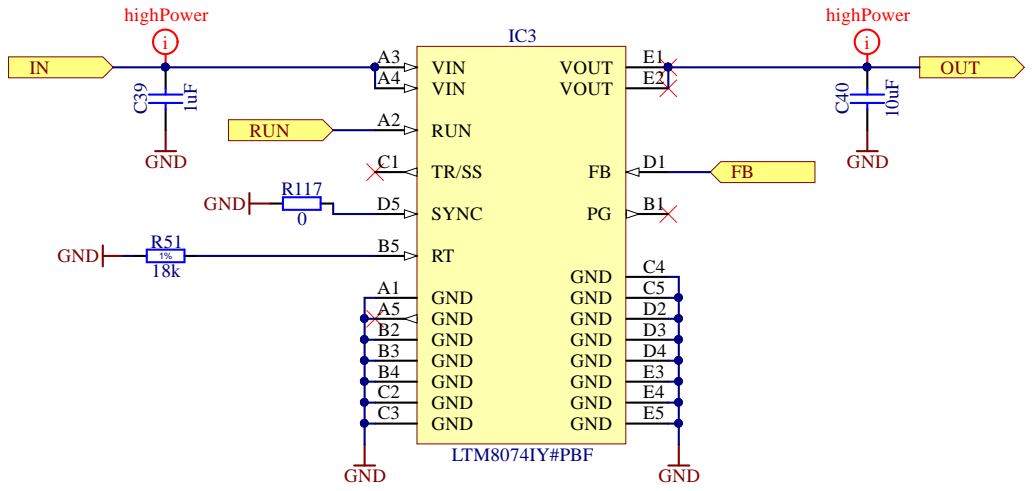
[picture p9: page 6]

1% | GND A1

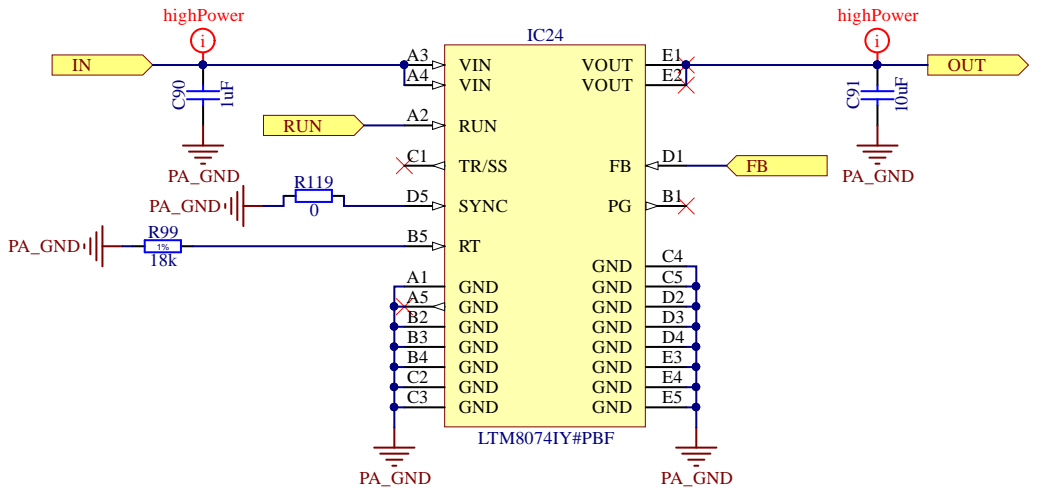
[picture p10: page 7]

1% | GND A1

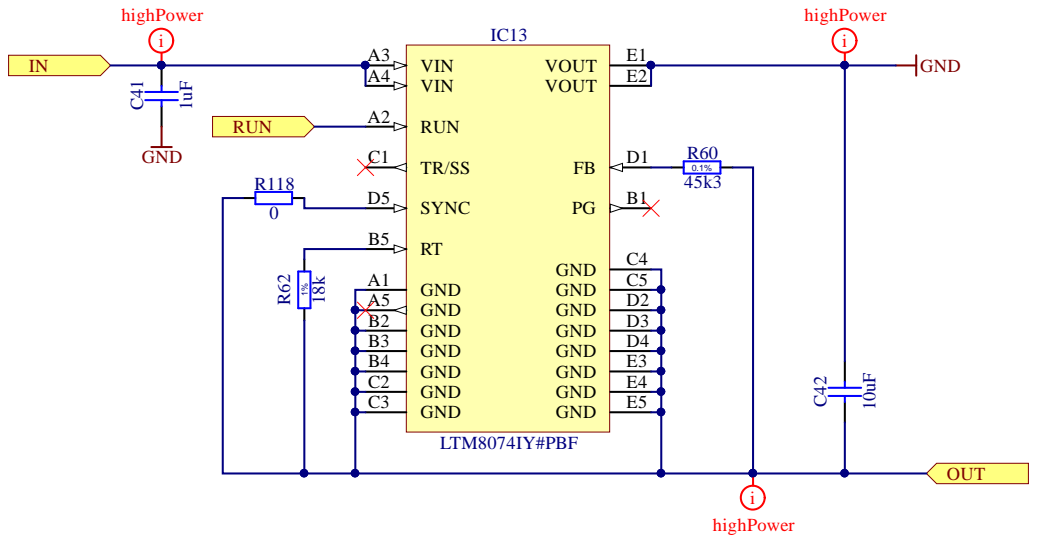
[picture p11: page 8]

EDA-XXXXX-VX-X Designer Designer Drawn by DrawnBy

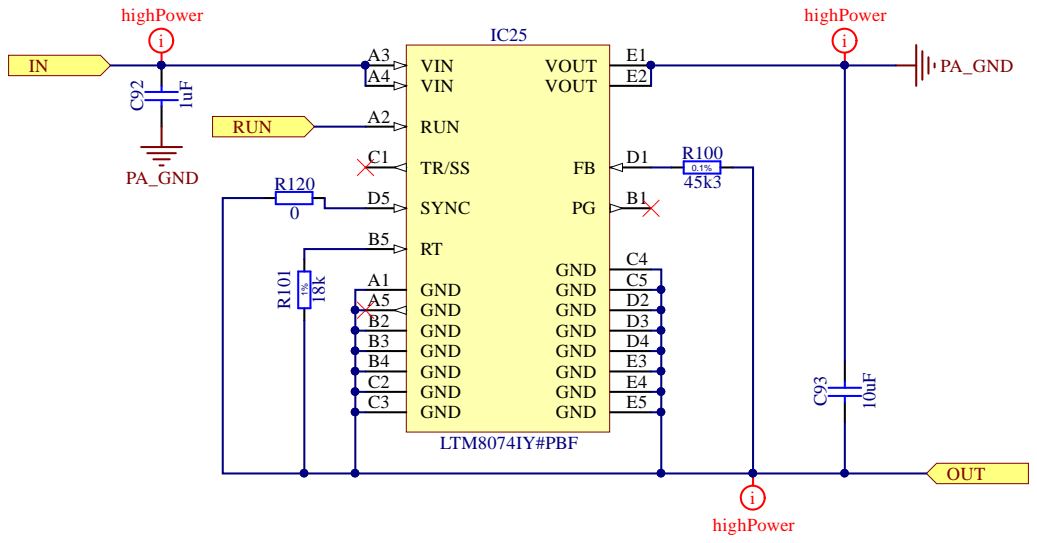
[picture p12: page 9]

EDA-XXXXX-VX-X Designer Designer Drawn by DrawnBy

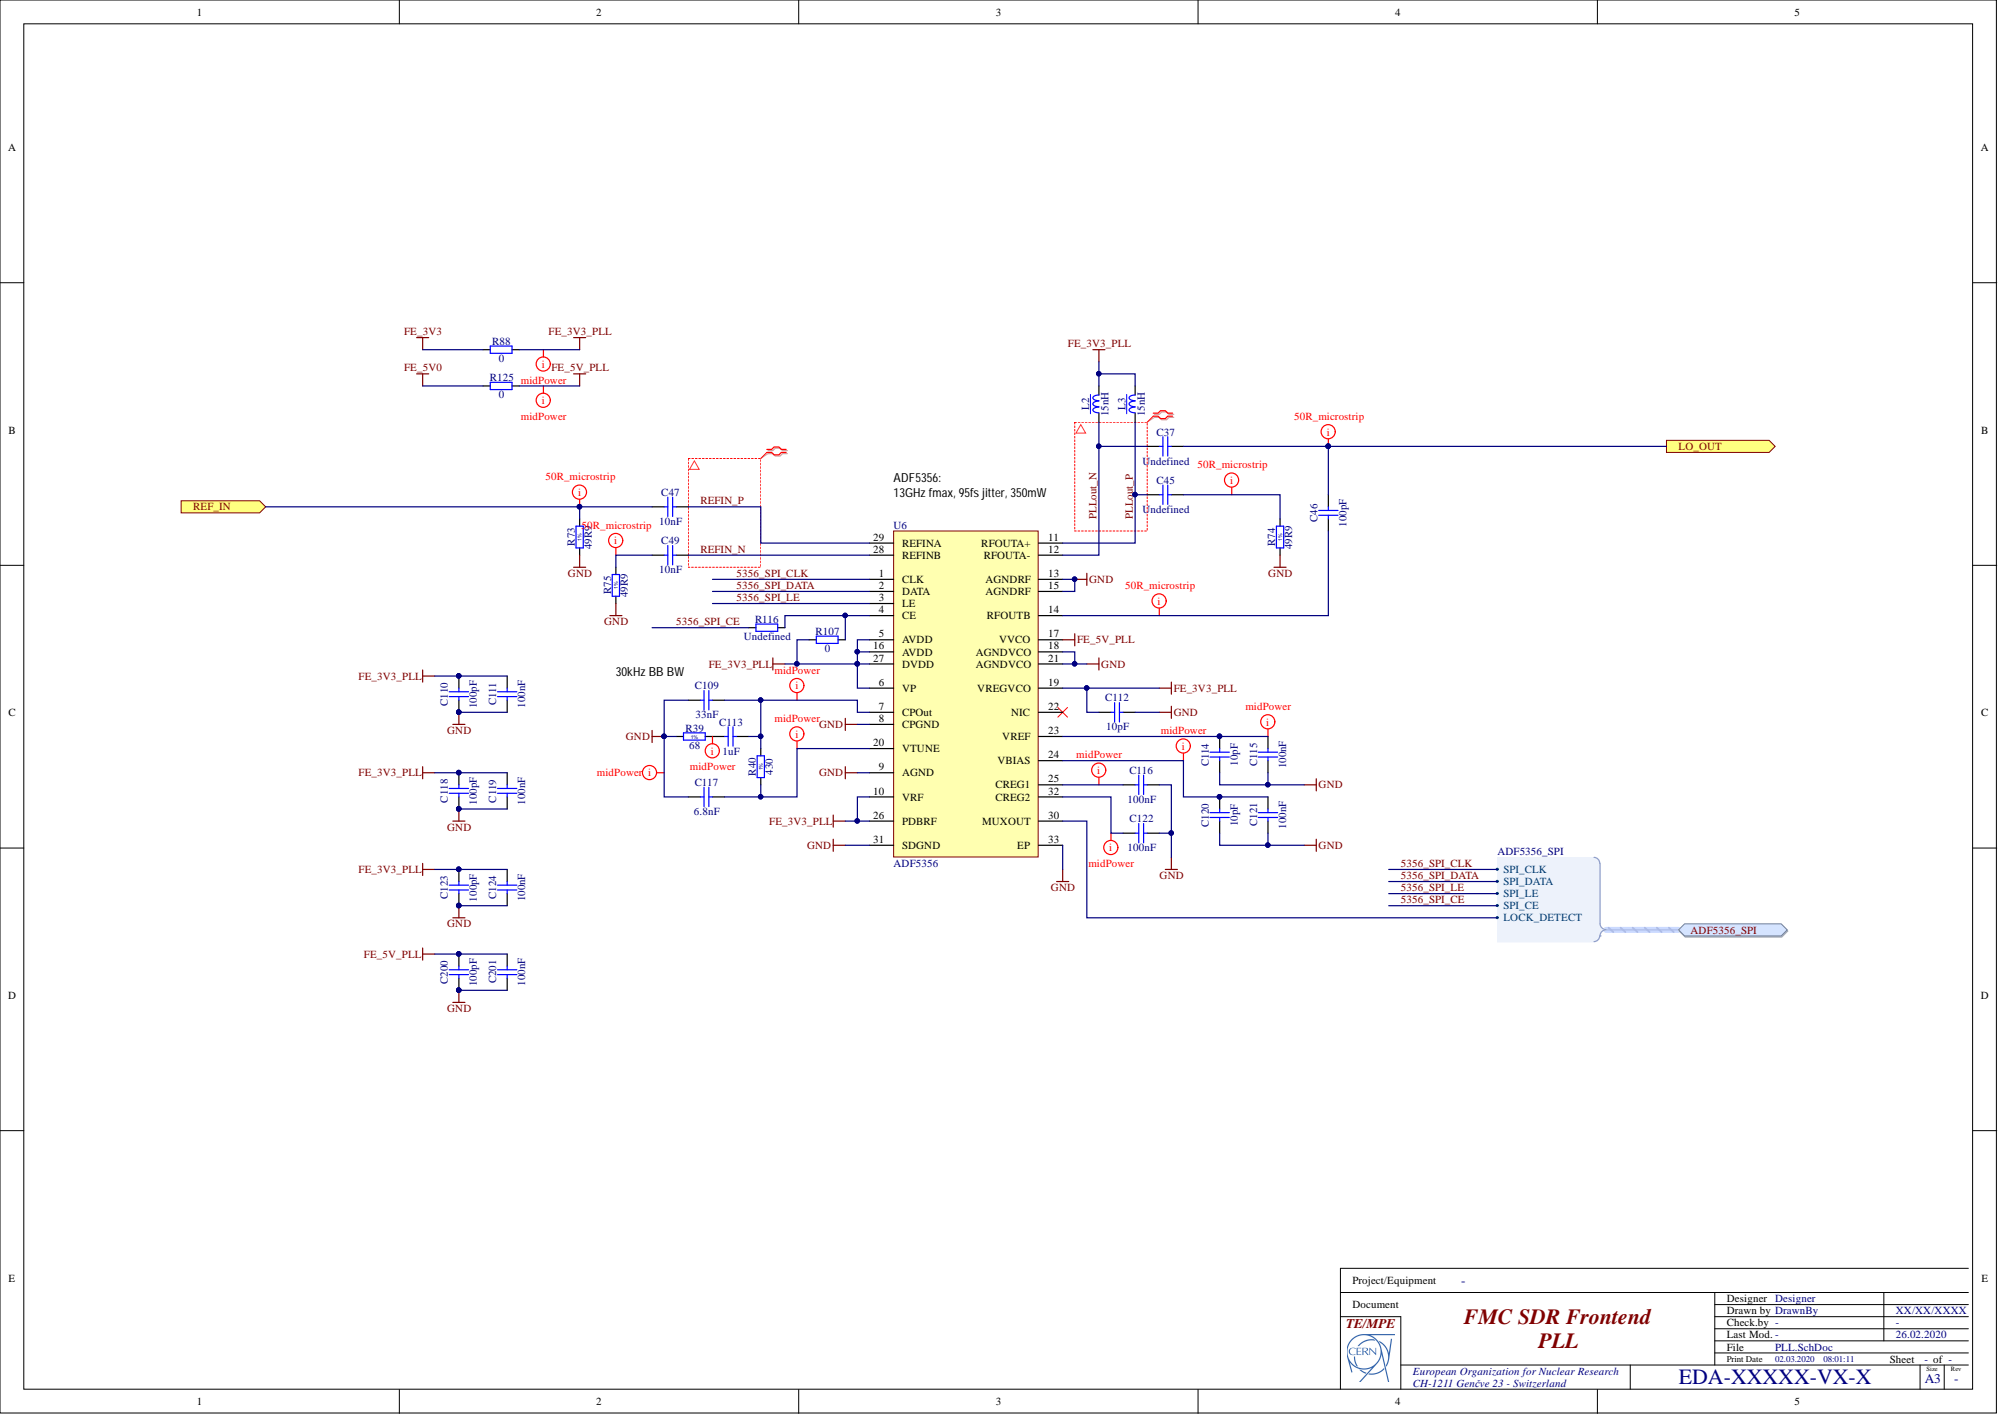
[picture p13: page 10]

3 3 | | | D | 5 3 5 6 _SPI_ D ATA 5 3 5 6 _SPI_ L E 5 3 5 6 _SPI_CE

EDA-XXXXX-VX-X Designer Designer Drawn by DrawnBy

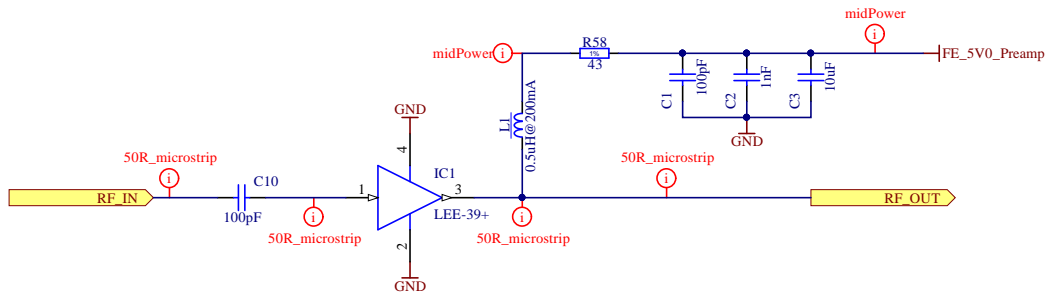
[picture p14: page 11]

Preamplifier - general GND reference

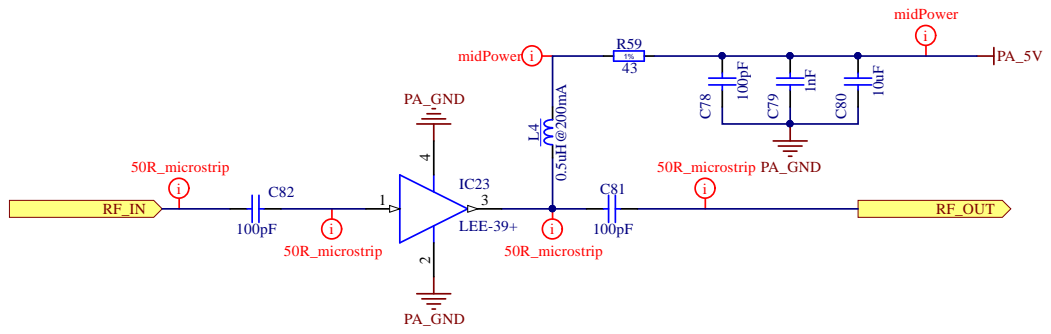
[picture p15: page 12]

Preamplifier - PA GND reference

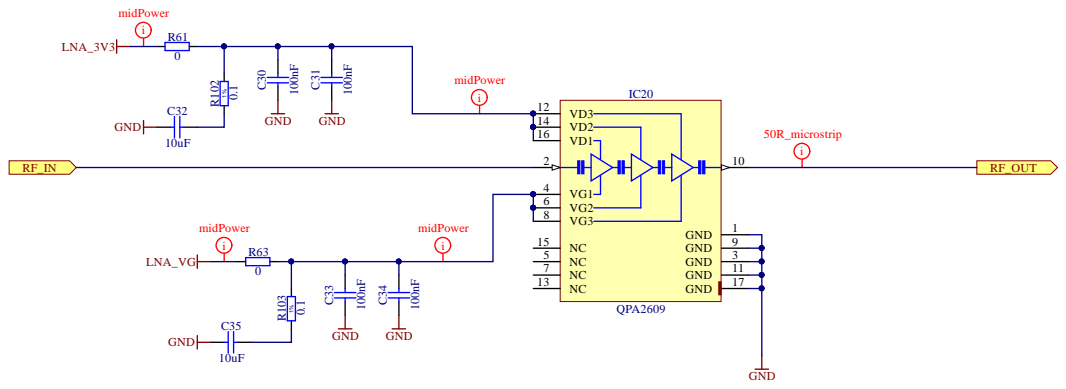
[picture p16: page 13]

EDA-XXXXX-VX-X Designer Designer Drawn by DrawnBy

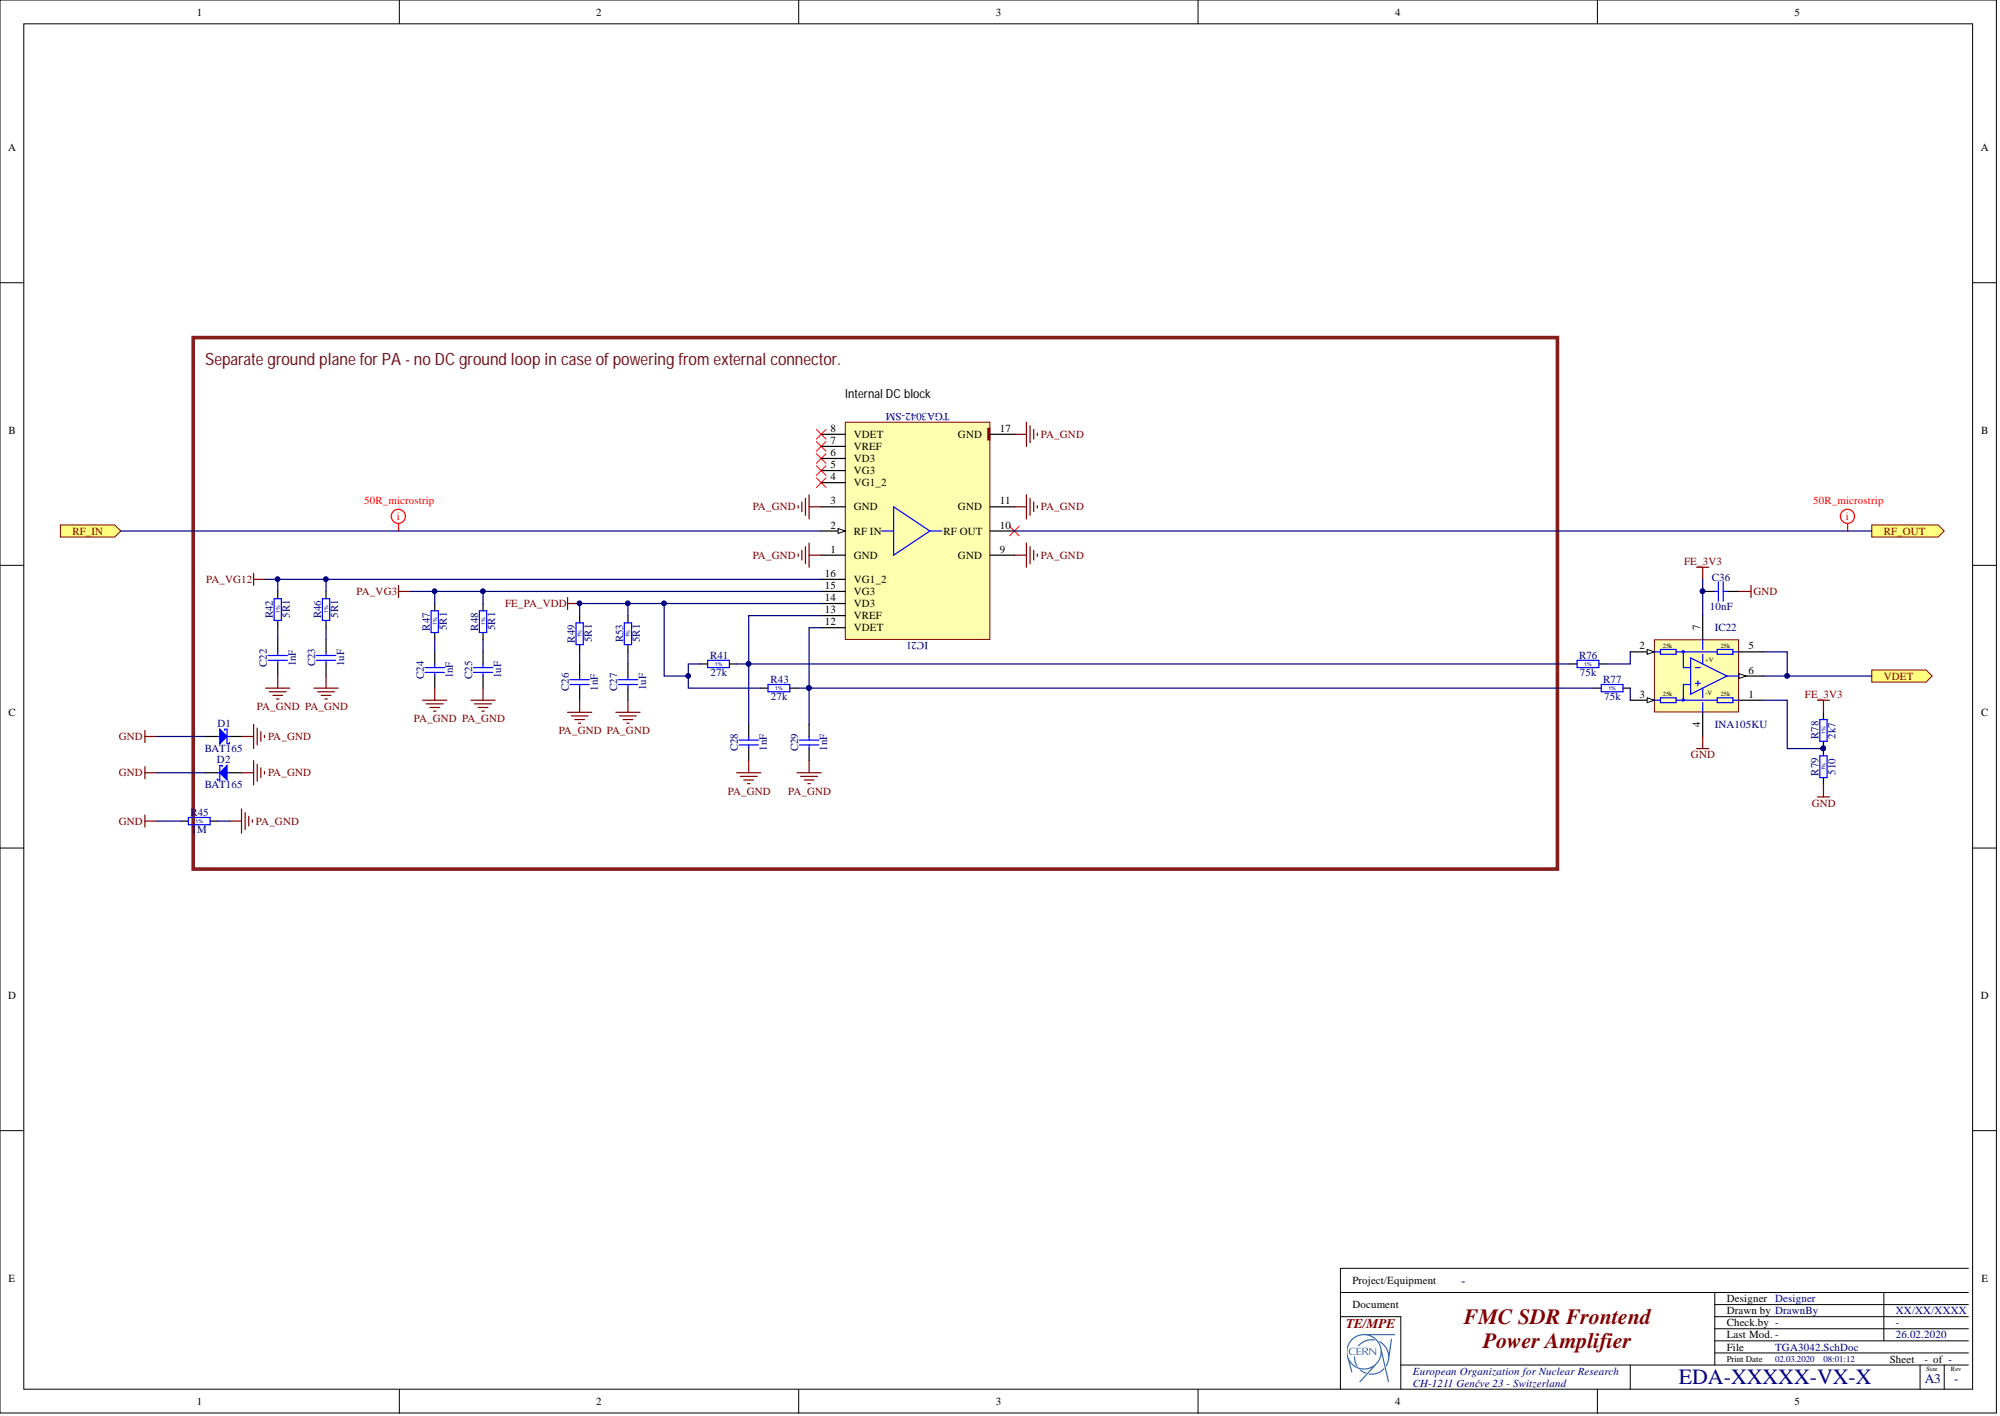
[picture p17: page 14]

in case of powering

VRE F V D 3 V G 3 V G 1 _ 2 V G 1 _ 2 V G 3 V D 3 VRE F V D E T

EDA-XXXXX-VX-X Designer Designer Drawn by DrawnBy
