elhep/FMC_SDR/FMC_SDR_XFE/FMC_SDR_XFE/Project Outputs for FMC_SDR_XFE/SCH_PDF.PDF

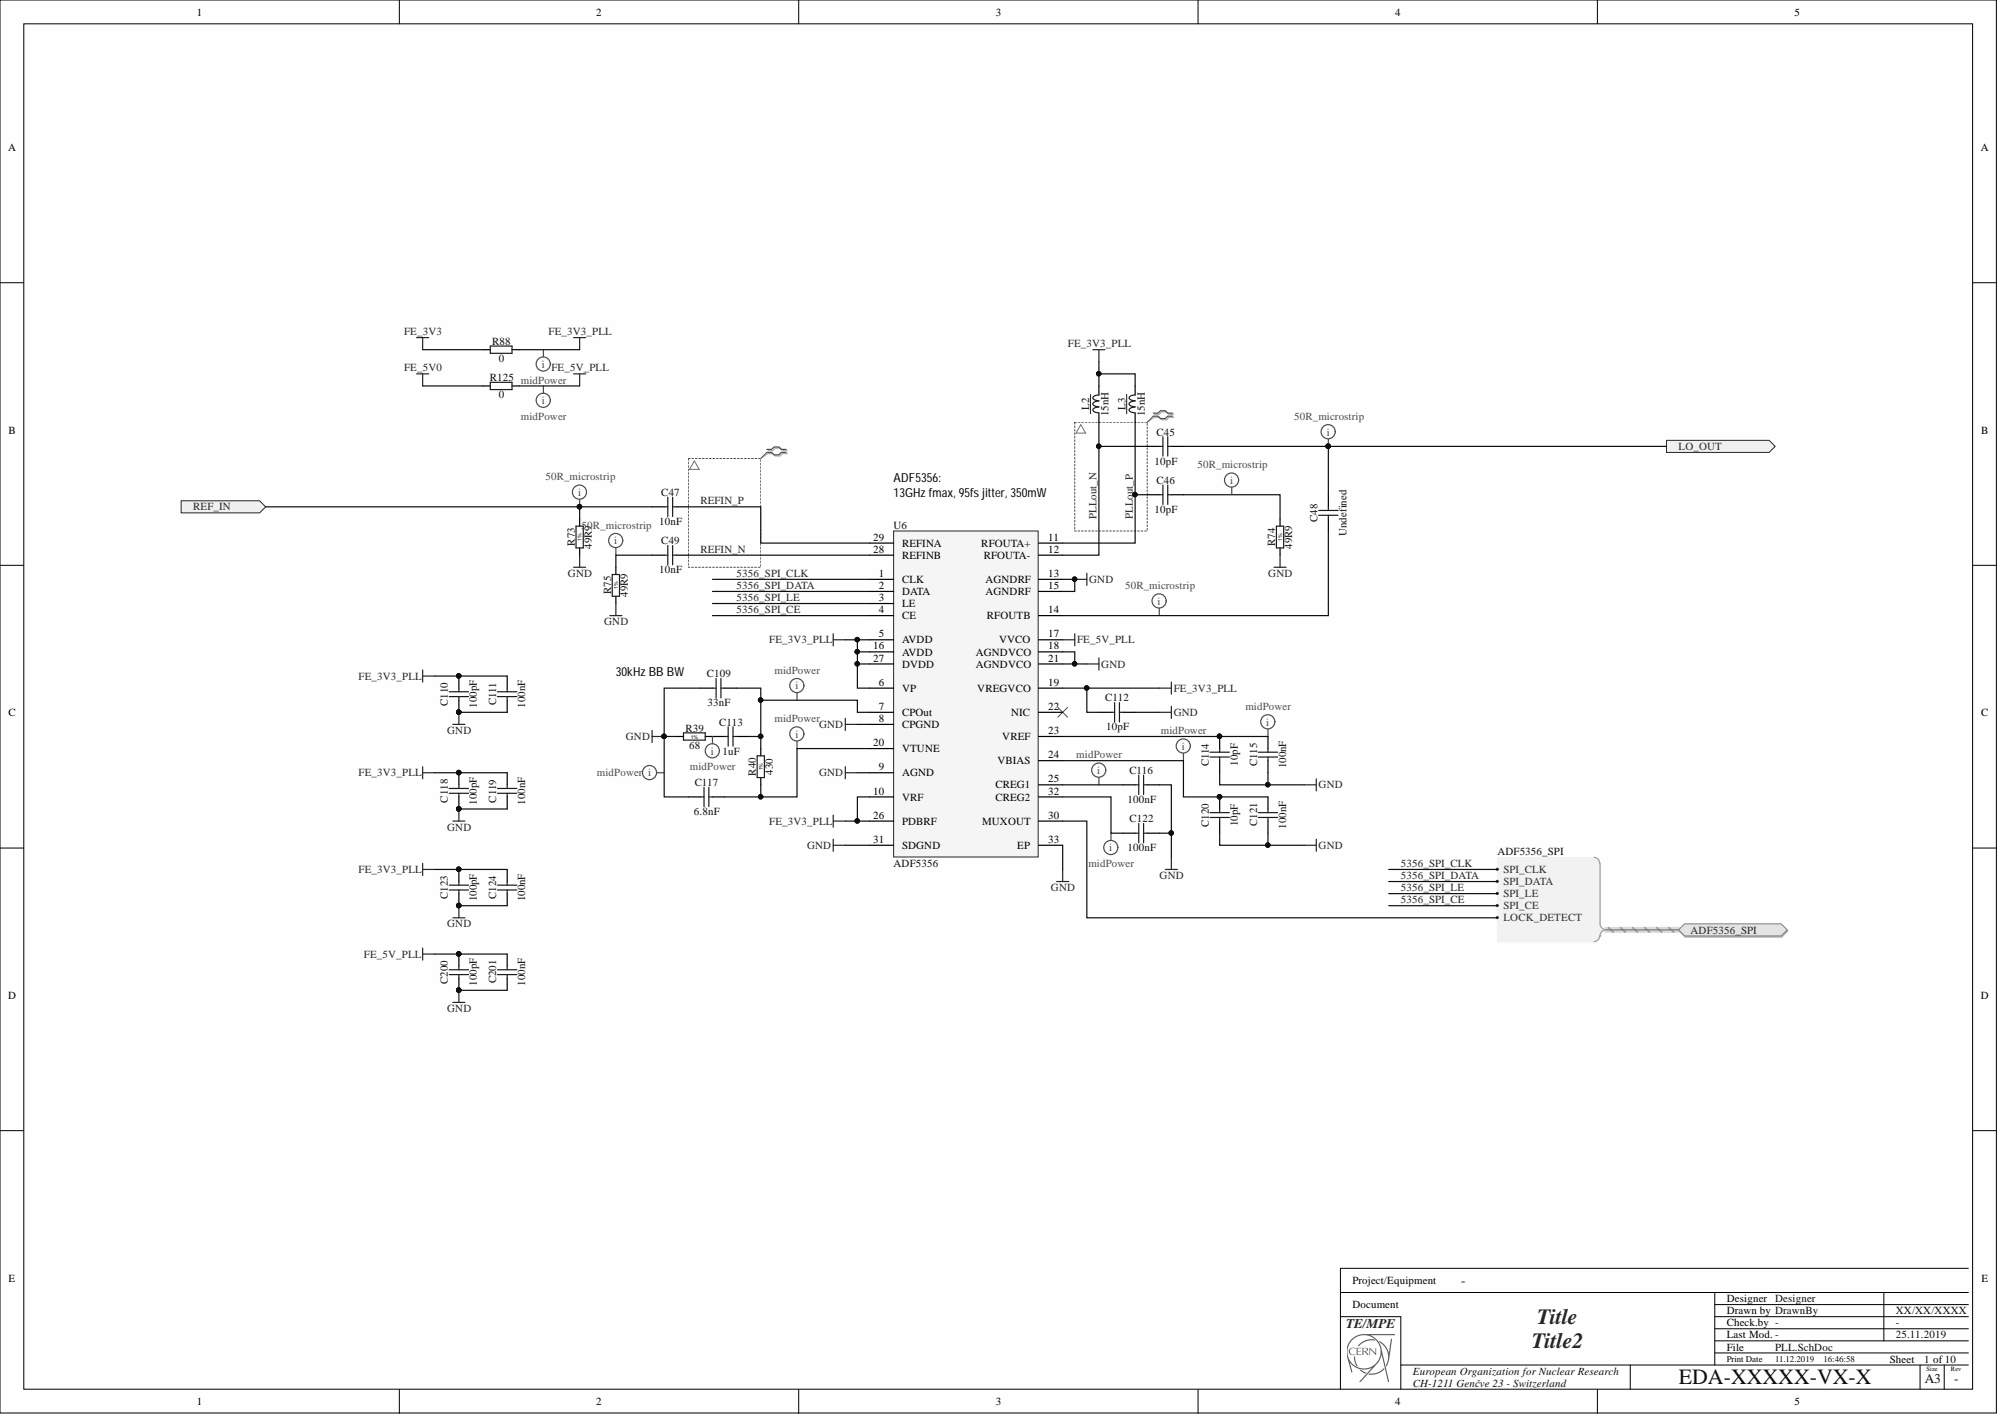
[picture p18: page 1]

1 6
2 7 | | 2 1

3 3 | | | D | 5 3 5 6 _SPI_ D ATA 5 3 5 6 _SPI_ L E 5 3 5 6 _SPI_CE

EDA-XXXXX-VX-X Designer Designer Drawn by DrawnBy

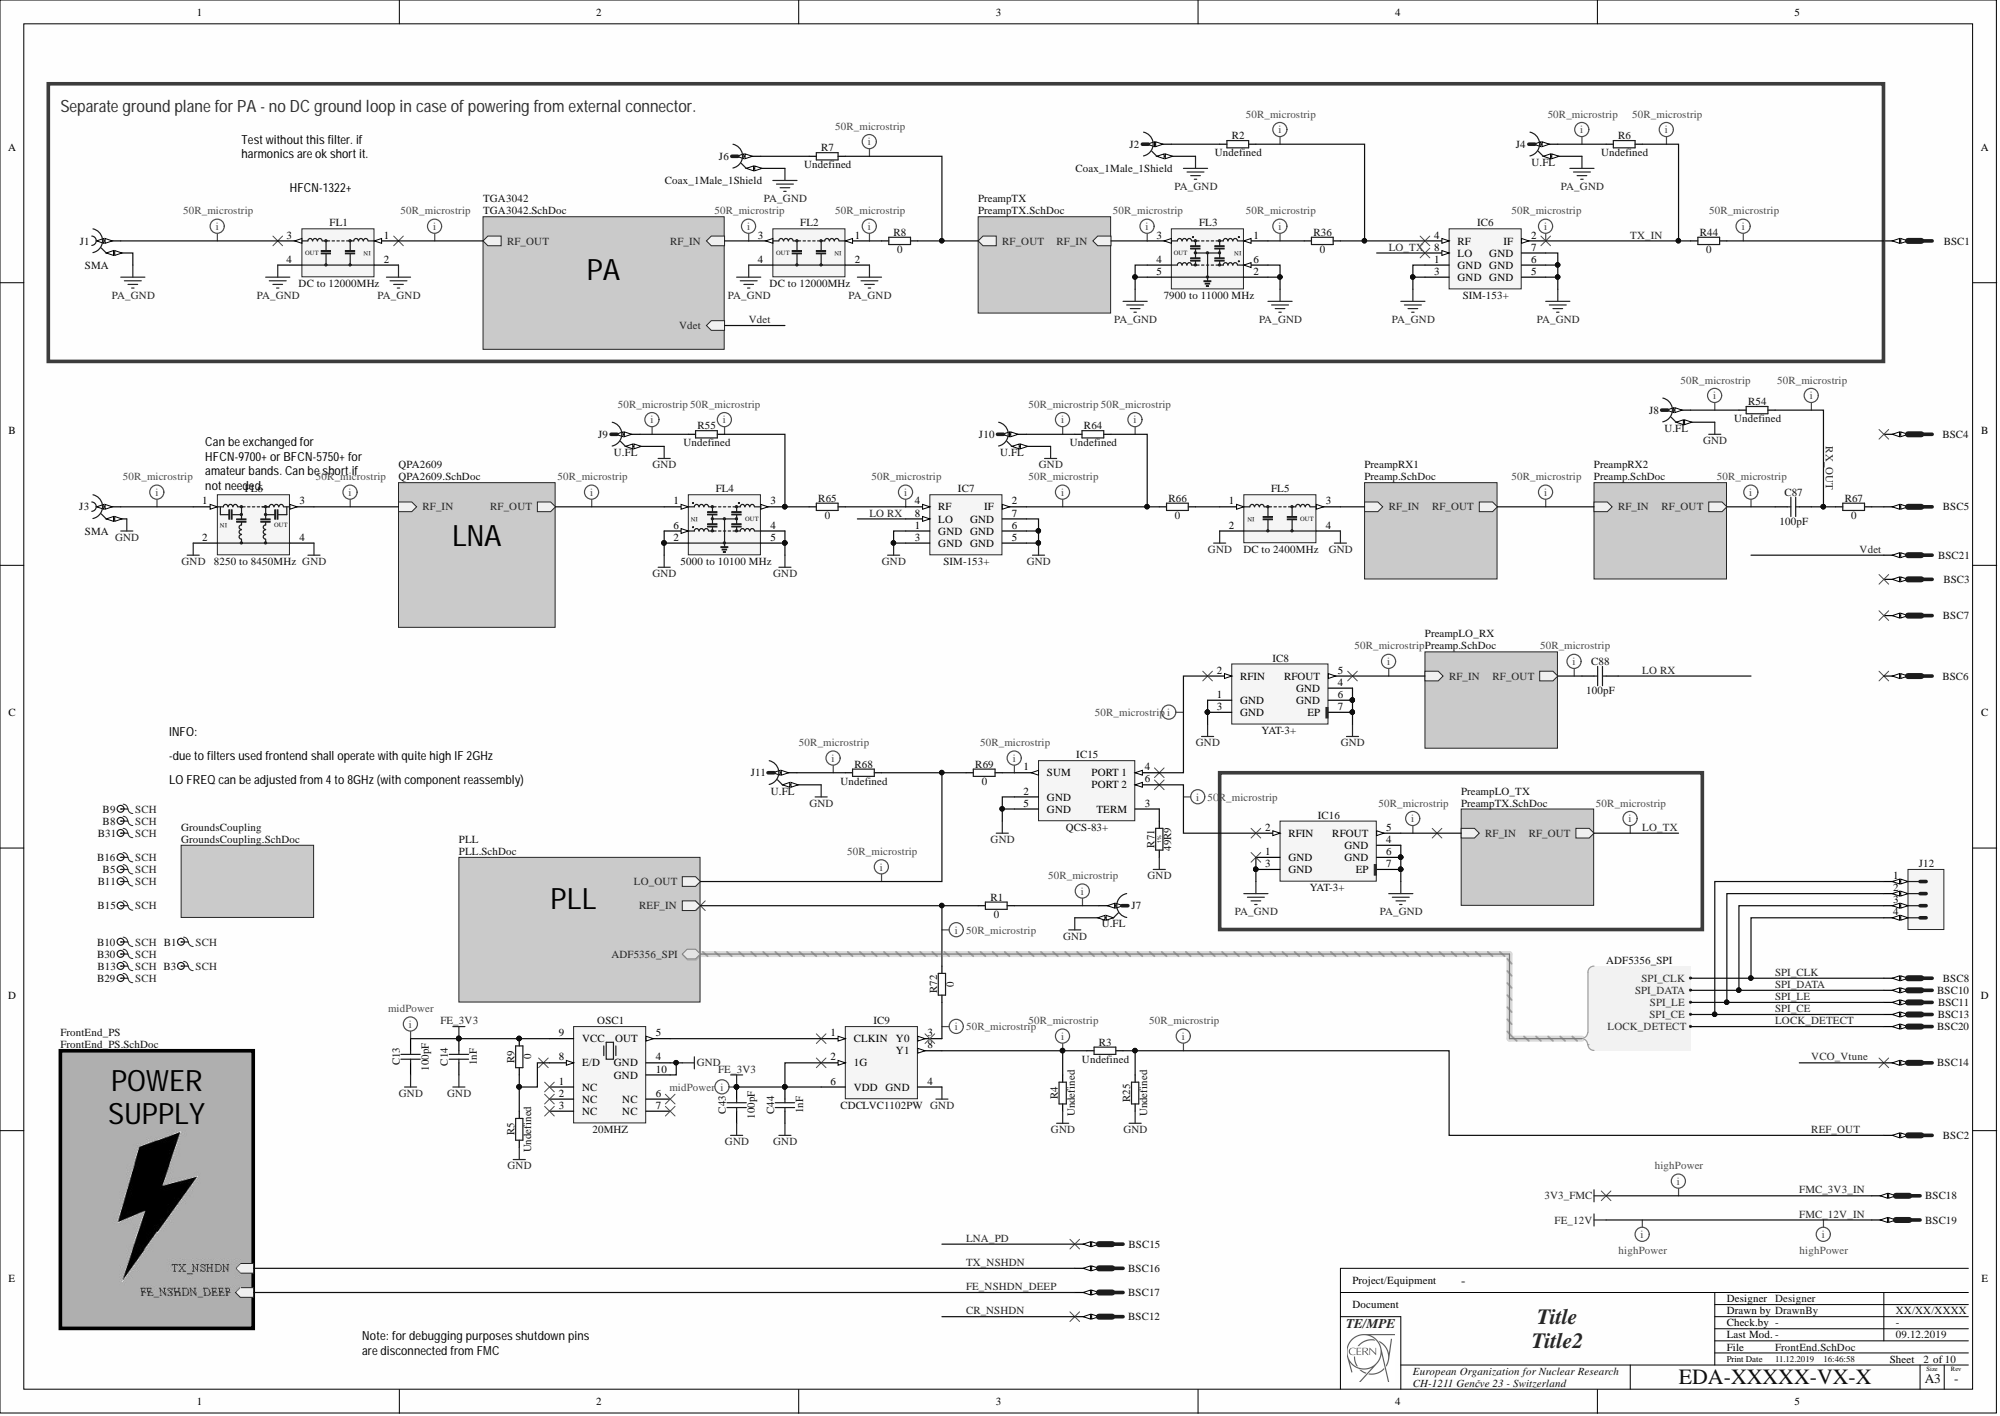
[picture p19: page 2]

Separate ground plane for PA - no DC ground loop in case of powering from external connector.

Test without this filter. if
harmonics are ok short it.

Can be exchanged for
HFCN-9700+ or BFCN-5750+ for
amateur bands. Can be short if
not needed.

-due to filters used frontend shall operate with quite high IF 2GHz

LO FREQ can be adjusted from 4 to 8GHz (with component reassembly)

Note: for debugging purposes shutdown pins
are disconnected from FMC

European Organization for Nuclear Research
CH-1211 Genčve 23 - Switzerland

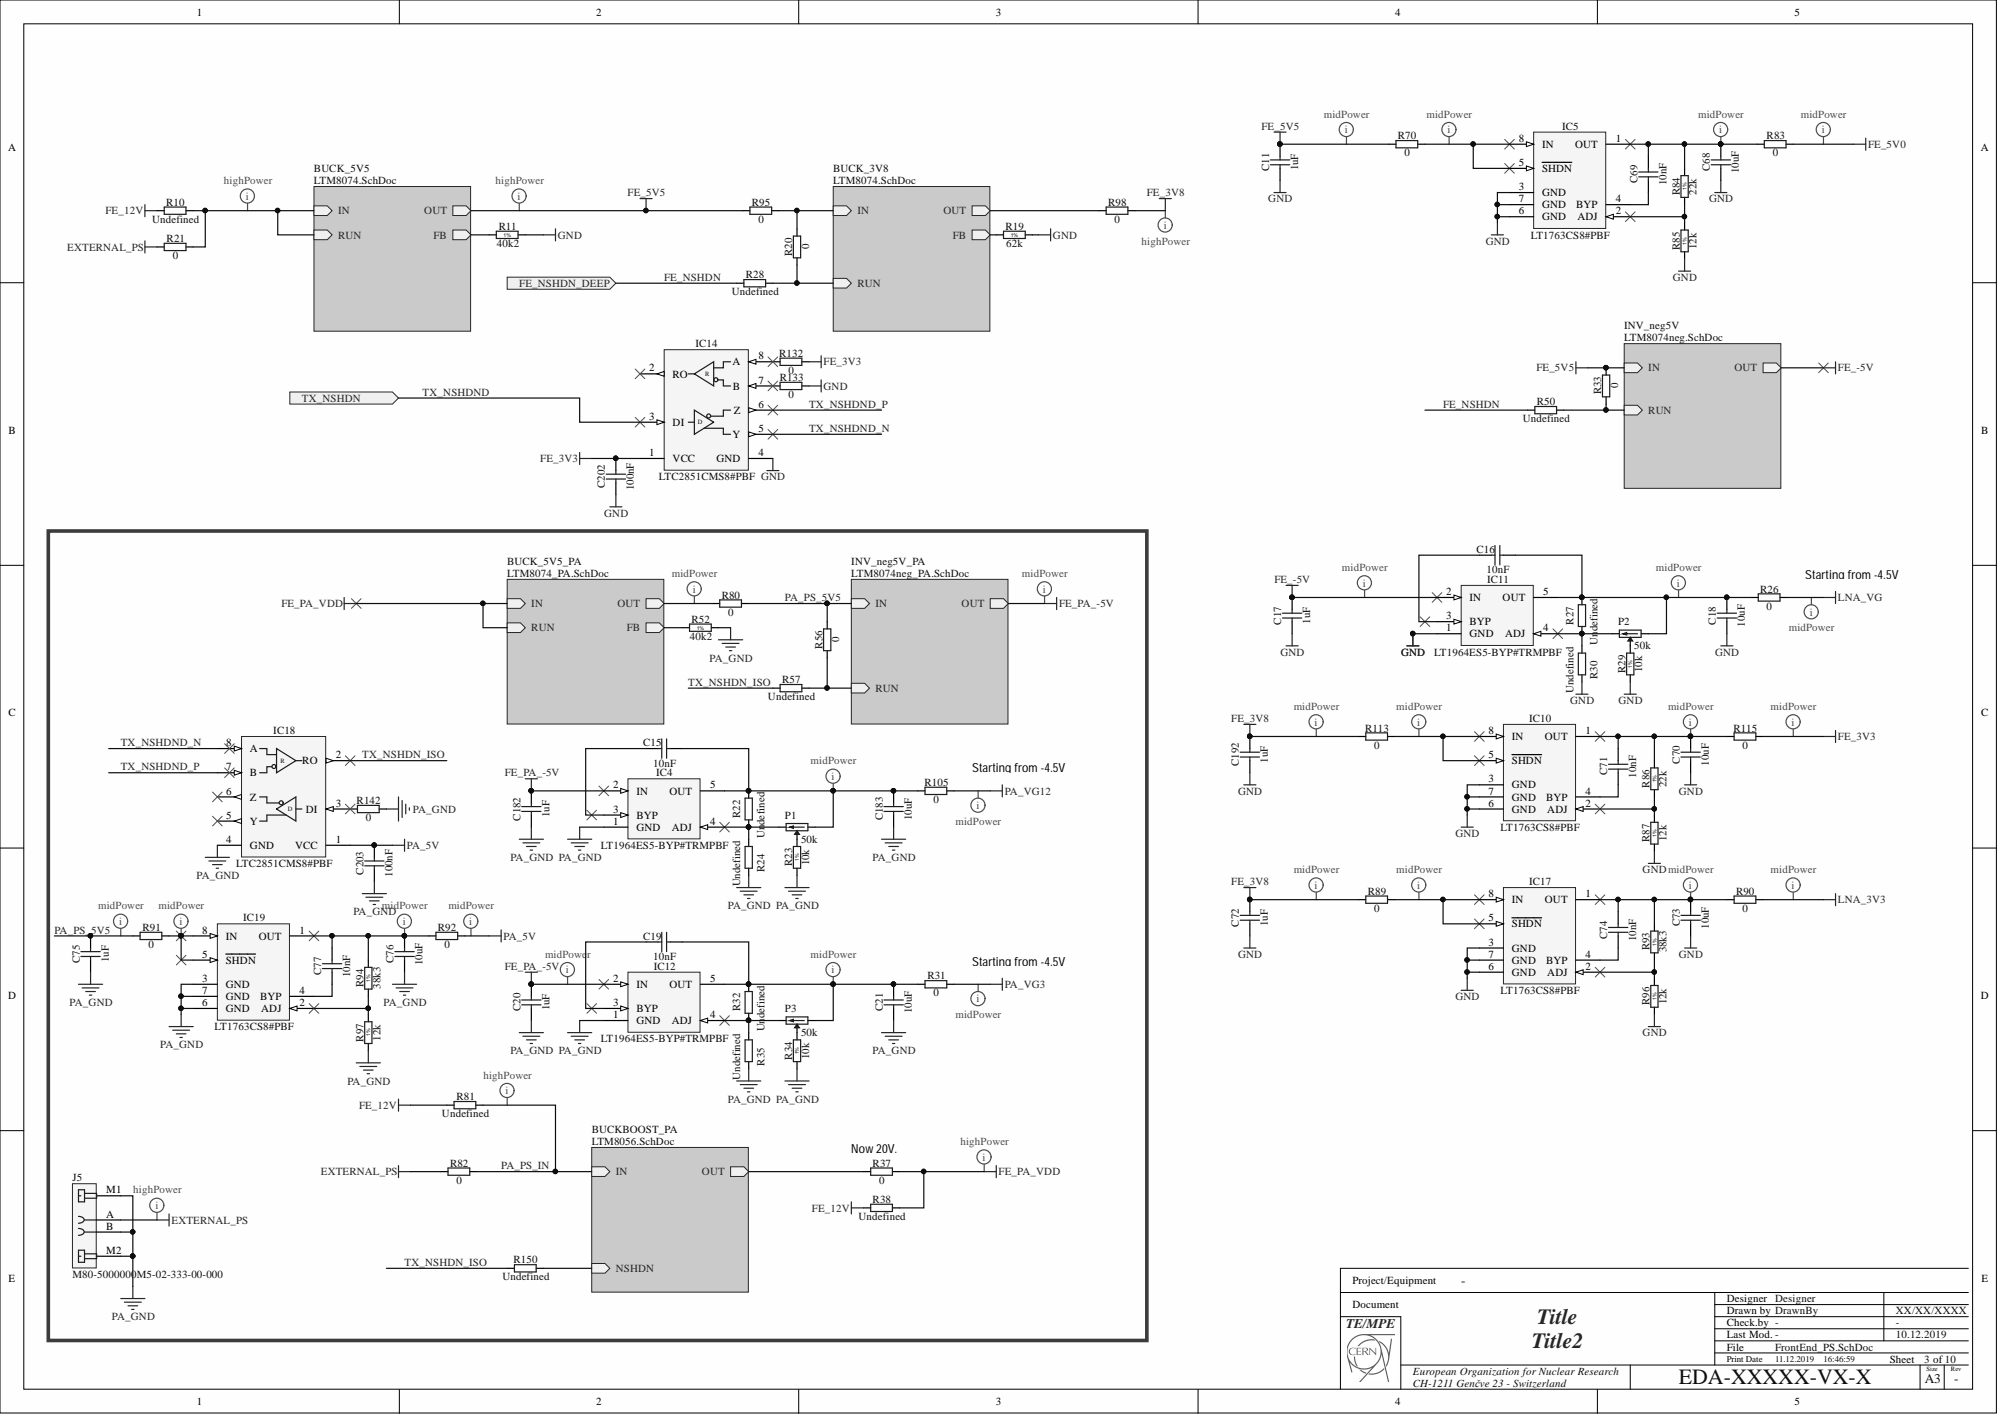
[picture p20: page 3]

European Organization for Nuclear Research
CH-1211 Genčve 23 - Switzerland

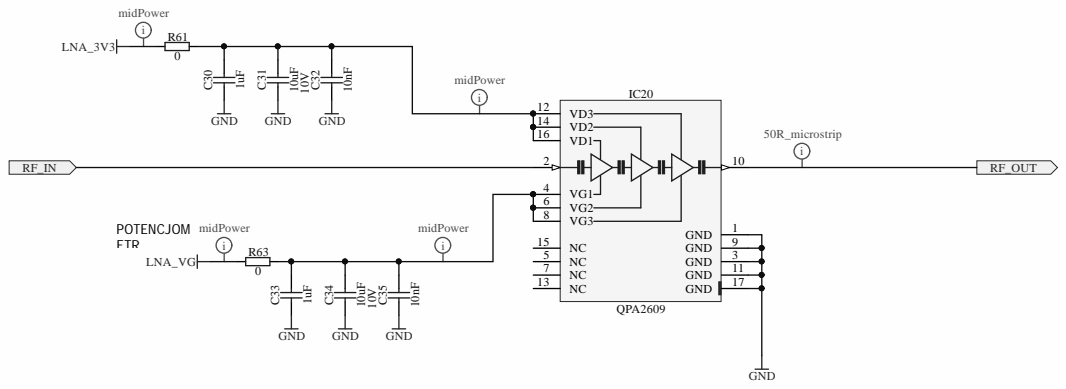
[picture p21: page 4]

EDA-XXXXX-VX-X Designer Designer Drawn by DrawnBy

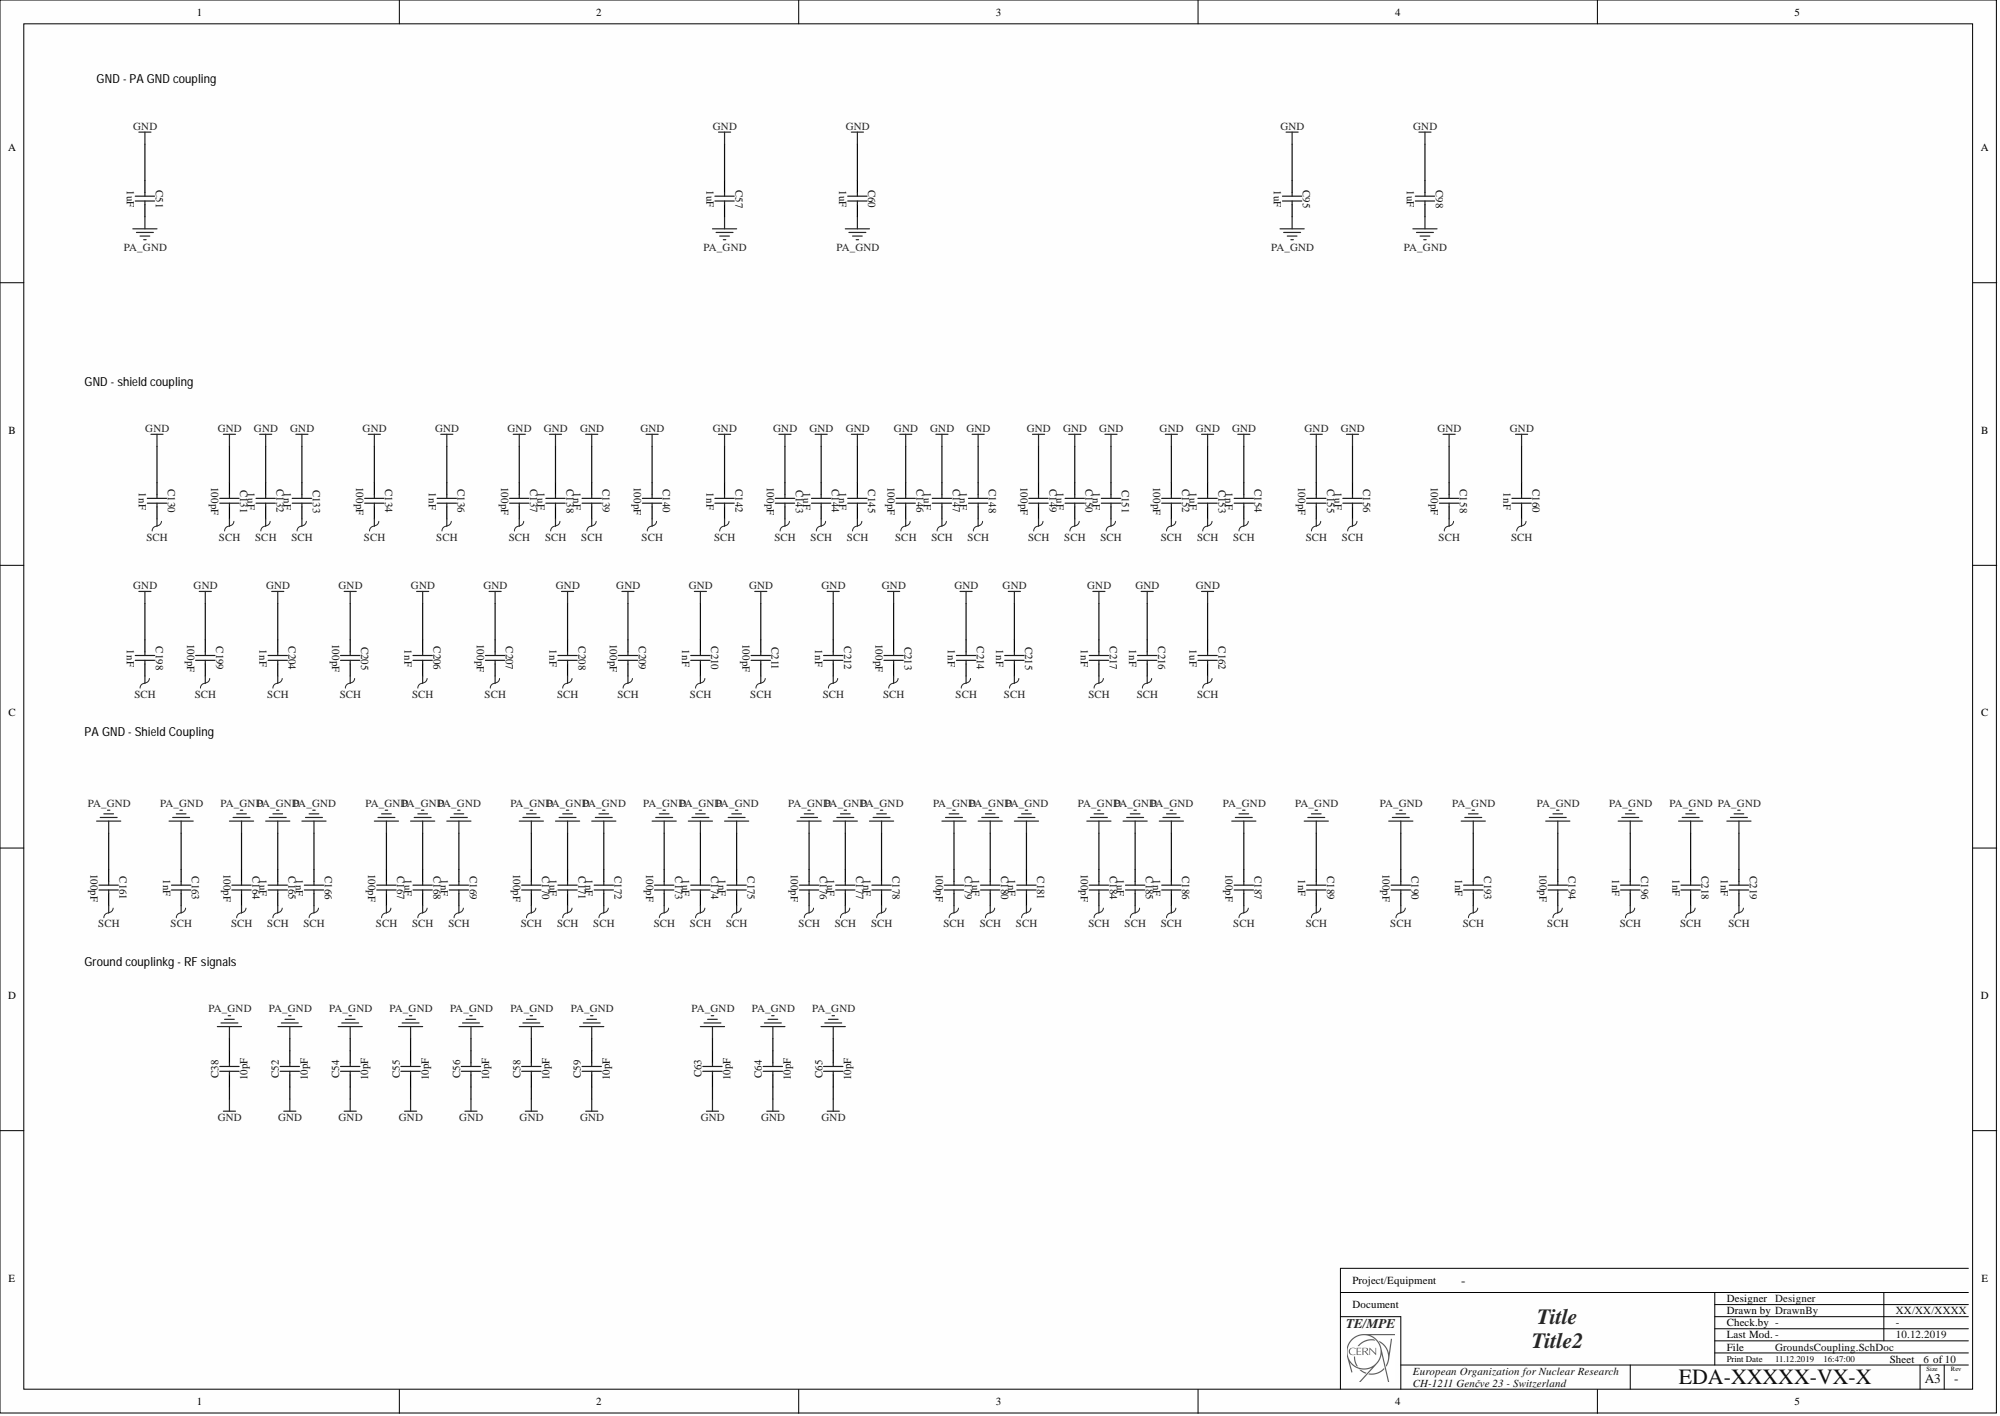
[picture p22: page 5]

GND - PA GND coupling

PA GND - Shield Coupling

Ground couplinkg - RF signals

European Organization for Nuclear Research
CH-1211 Genčve 23 - Switzerland

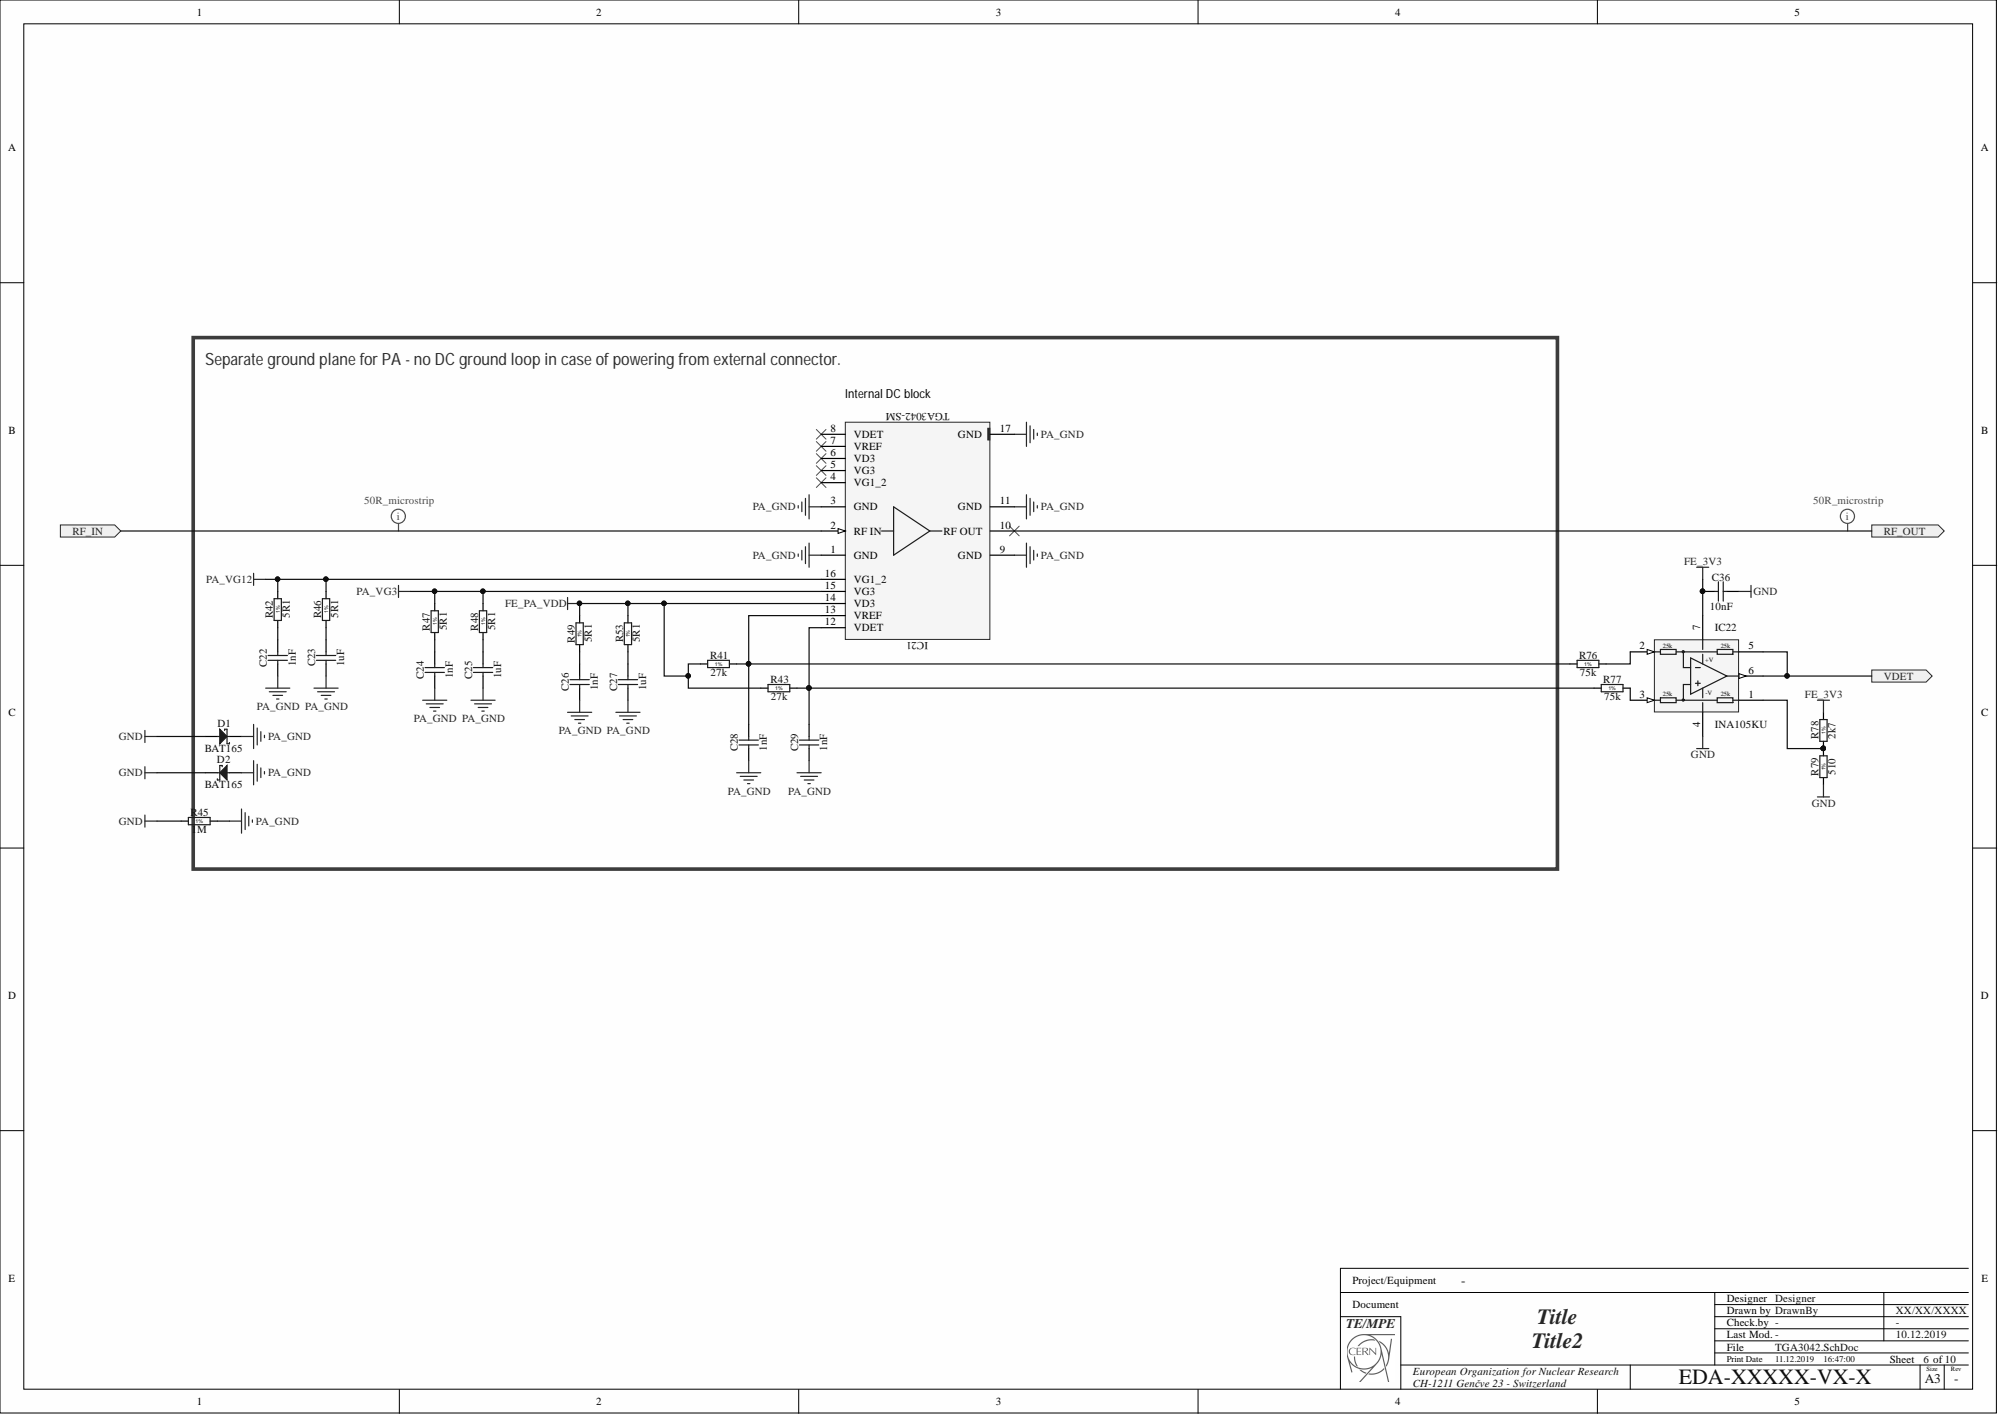
[picture p23: page 6]

in case of powering

VRE F V D 3 V G 3 V G 1 _ 2 V G 1 _ 2 V G 3 V D 3 VRE F V D E T

EDA-XXXXX-VX-X Designer Designer Drawn by DrawnBy

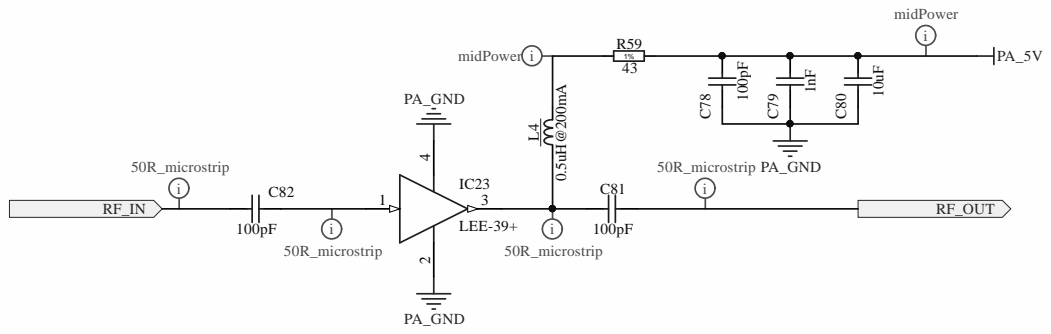
[picture p24: page 7]

EDA-XXXXX-VX-X Designer Designer Drawn by DrawnBy

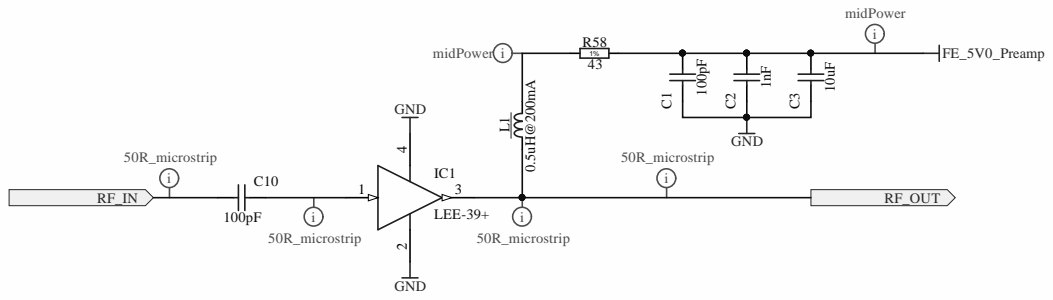
[picture p25: page 8]

EDA-XXXXX-VX-X Designer Designer Drawn by DrawnBy

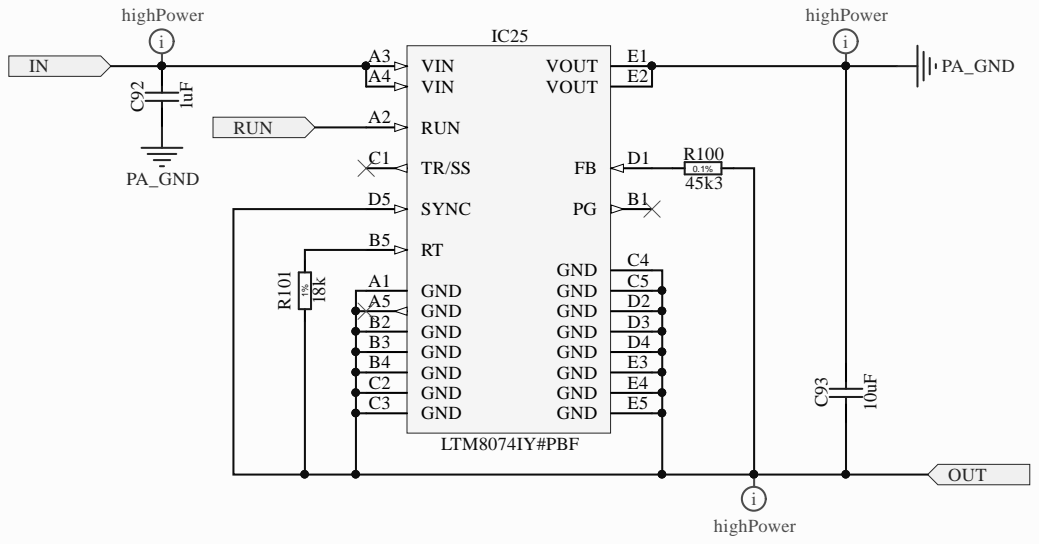
[picture p26: page 9]

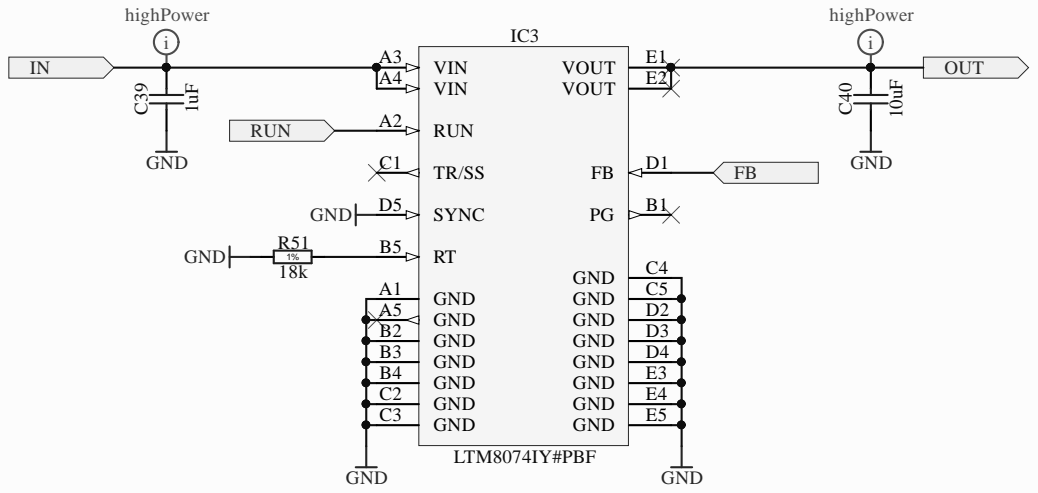
[picture p27: page 10]

1% | GND A1

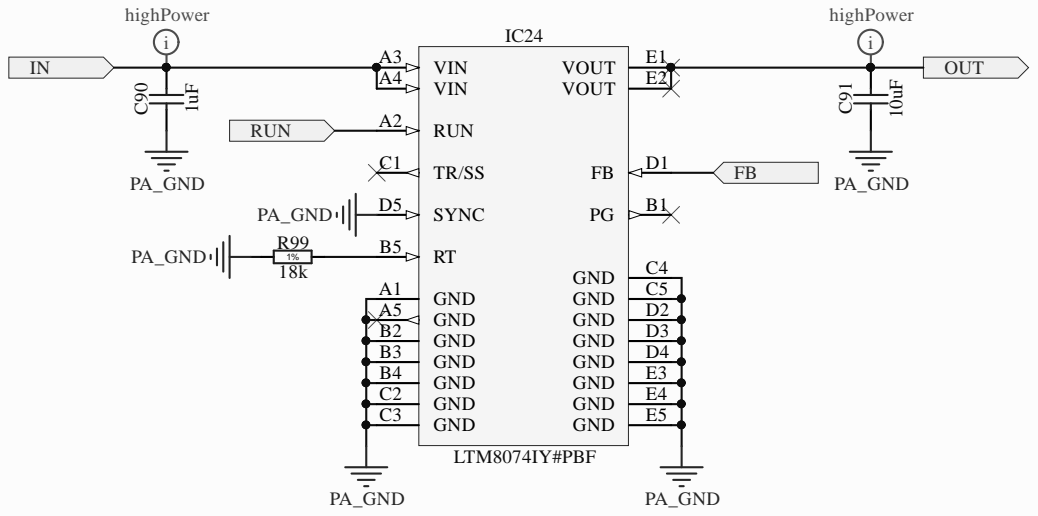
[picture p28: page 11]

1% | GND A1

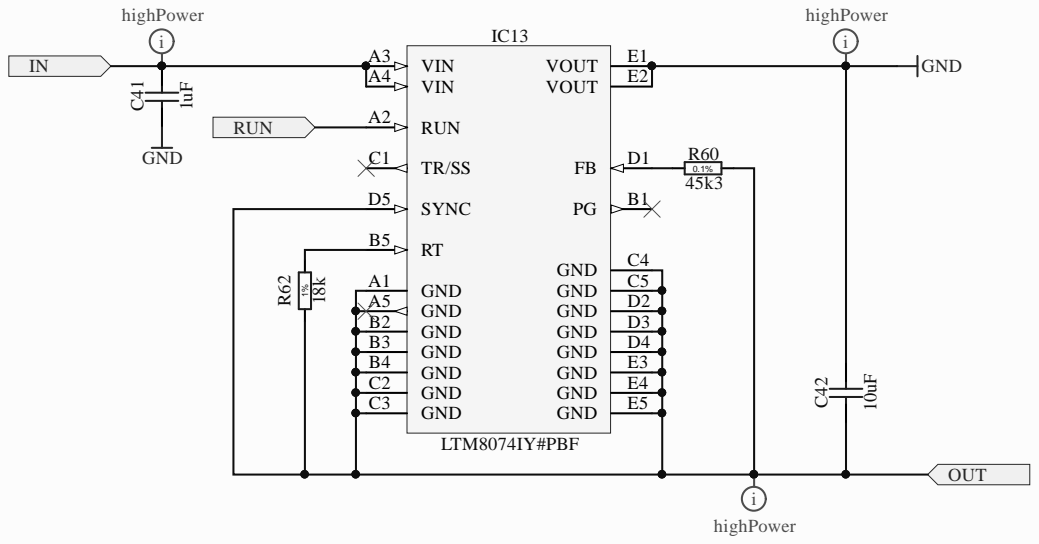
[picture p29: page 12]

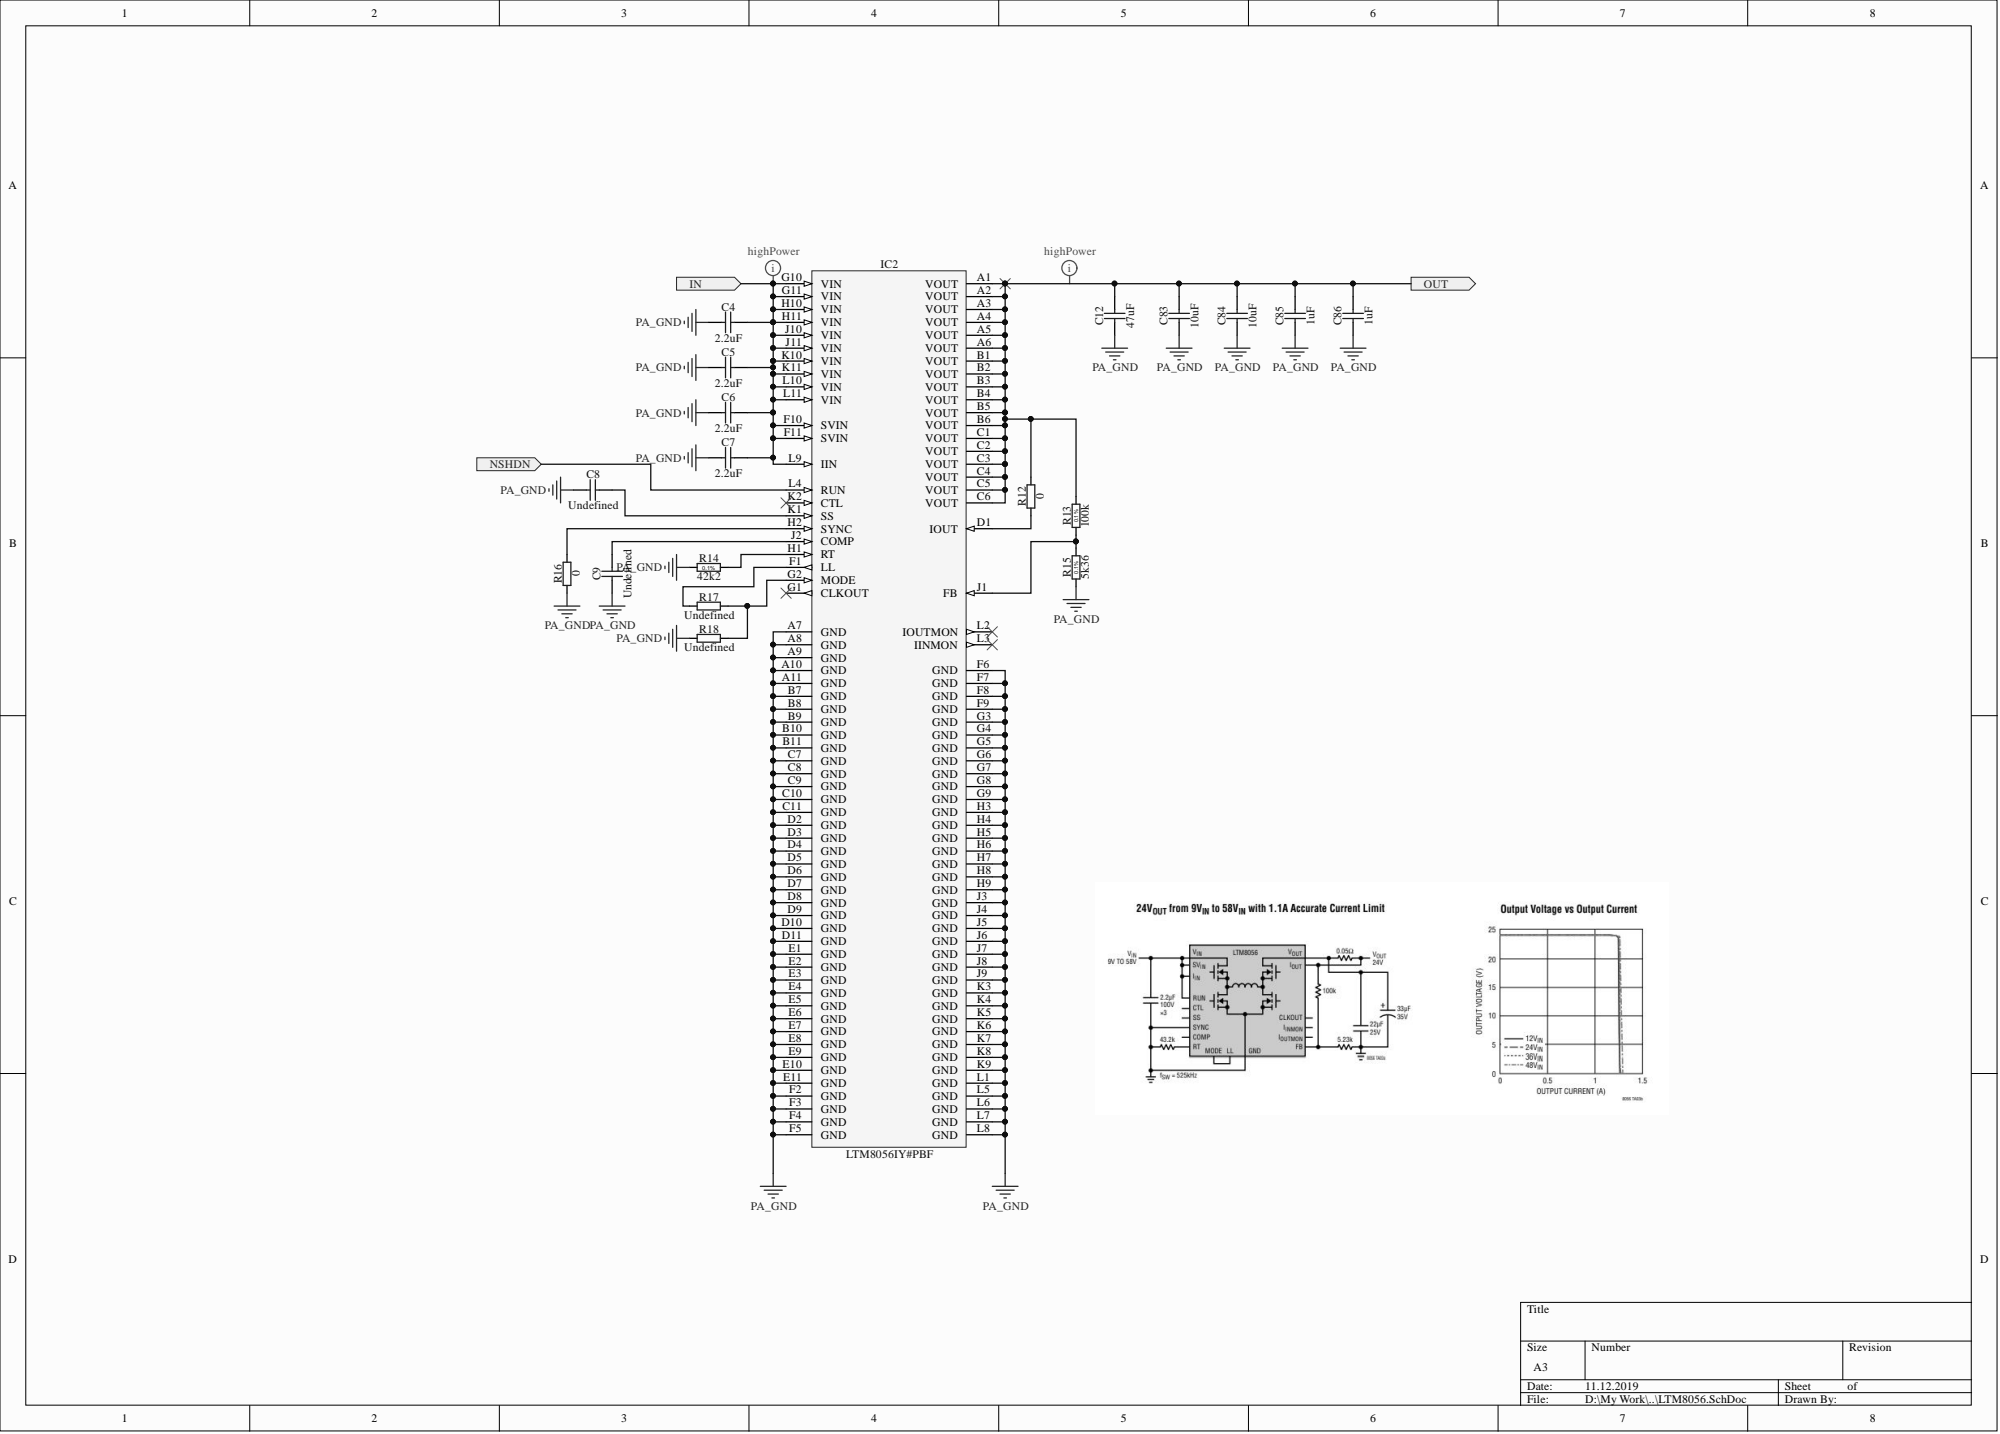
[picture p30: page 13]

VIN K11
VIN L10

2.2uF | RUN L4

SS K1 CTL K2

COMP J2
RT H1

R14 | | LL F1
0.1% | | CLKOUT G1 MODE G2
