elhep/FMC_SDR/FMC_SDR/FMC_SDR/Project Outputs for FMC_SDR/SCH.PDF

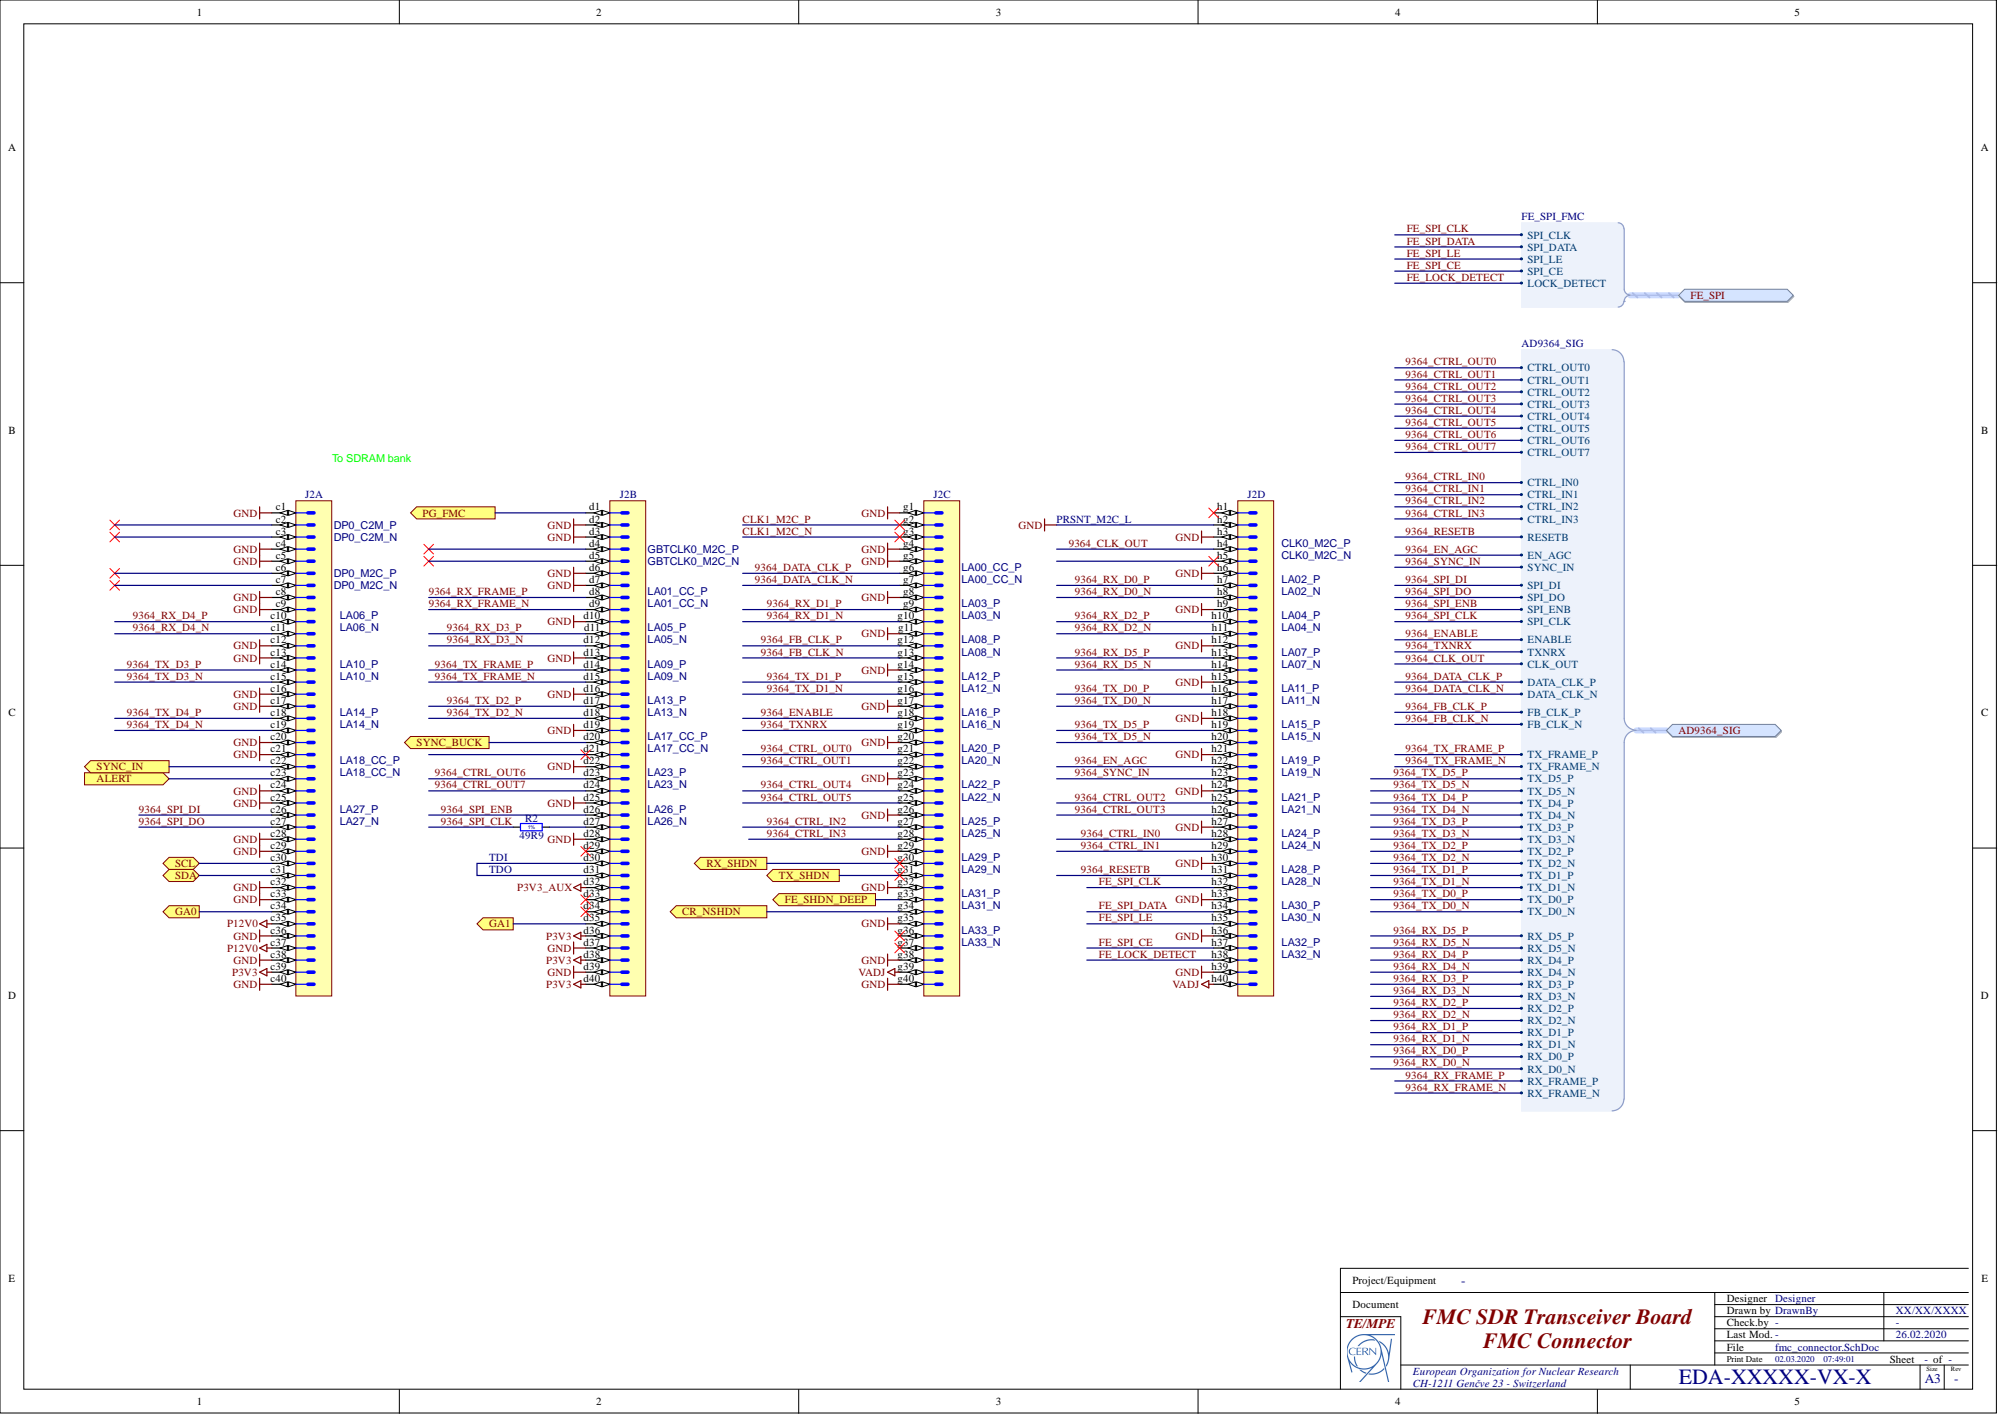
[picture p37: page 1]

EDA-XXXXX-VX-X Designer Designer Drawn by DrawnBy

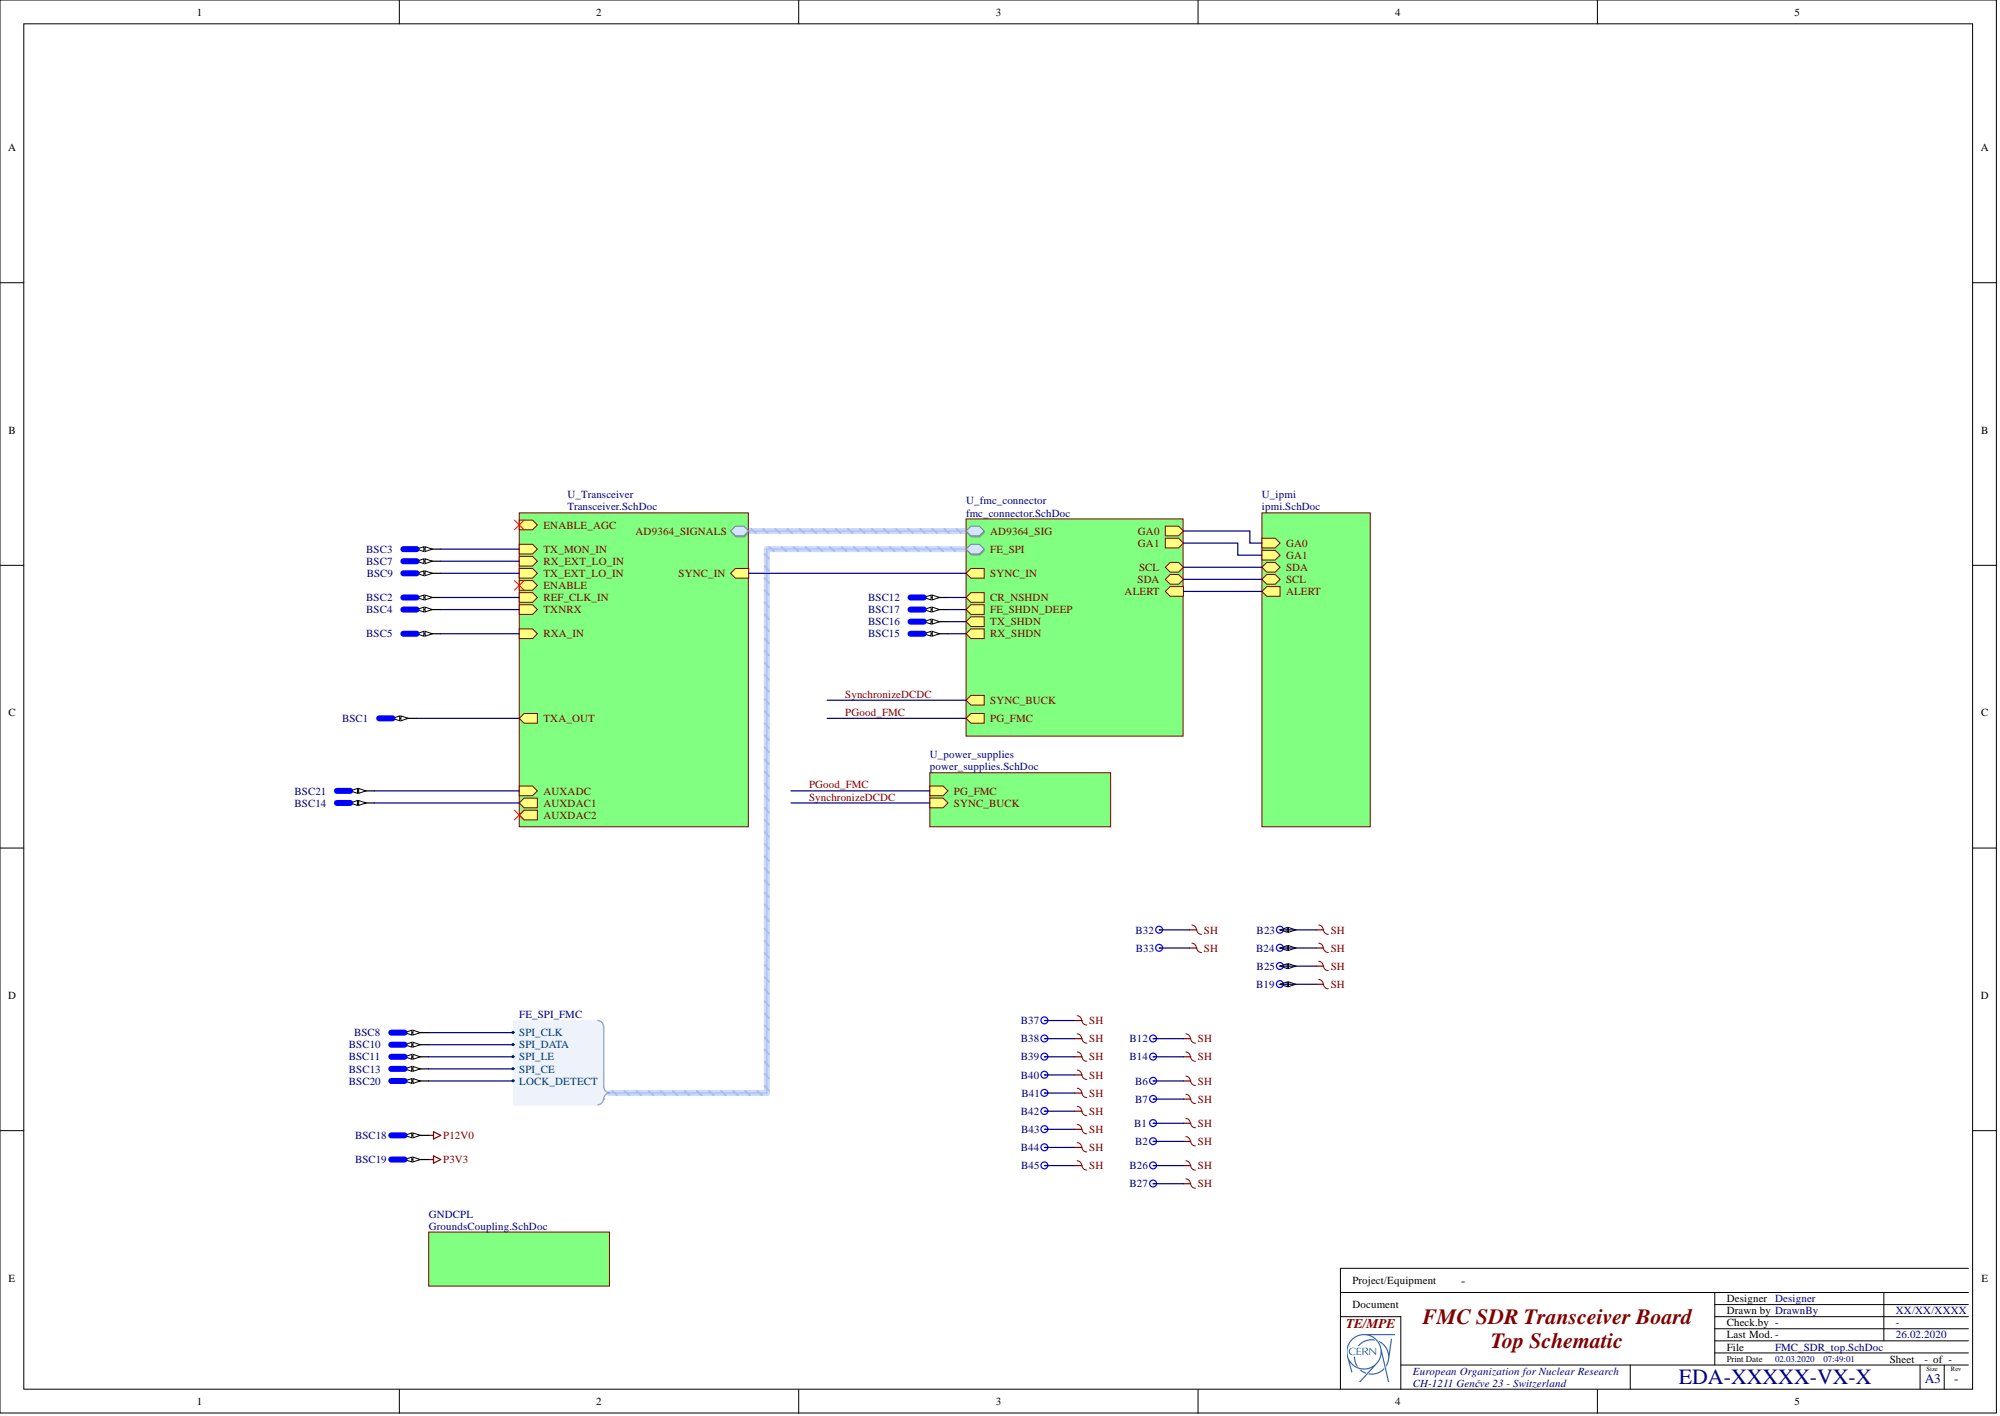
[picture p38: page 2]


European Organization for Nuclear Research
CH-1211 Genčve 23 - Switzerland


1 9 | 1 3
2 0

4 | 1 6

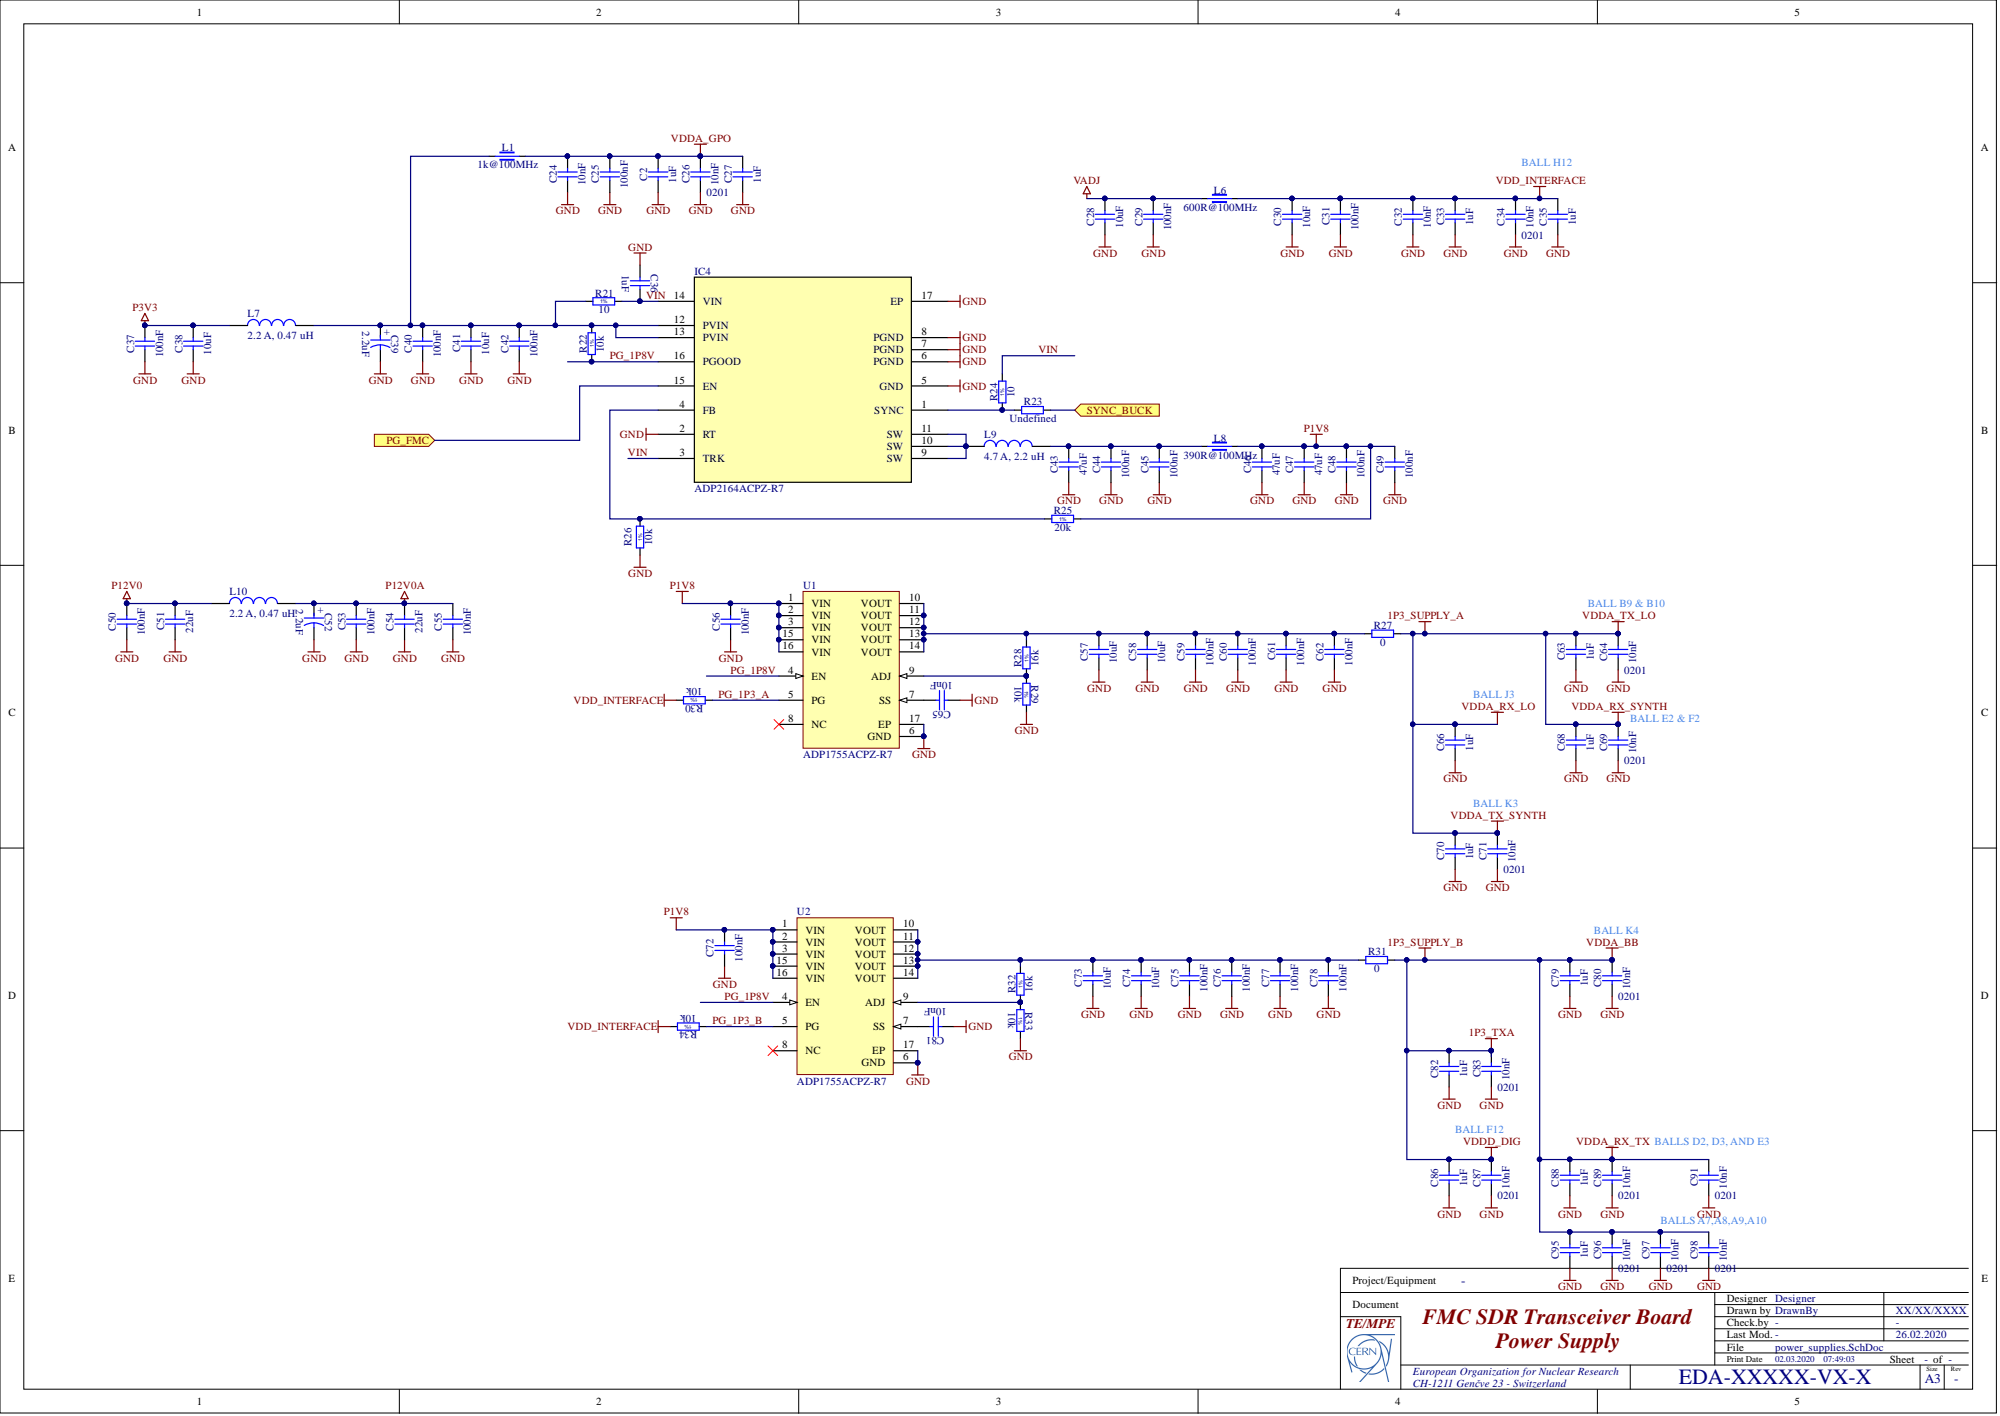
[picture p39: page 5]

European Organization for Nuclear Research
CH-1211 Genčve 23 - Switzerland

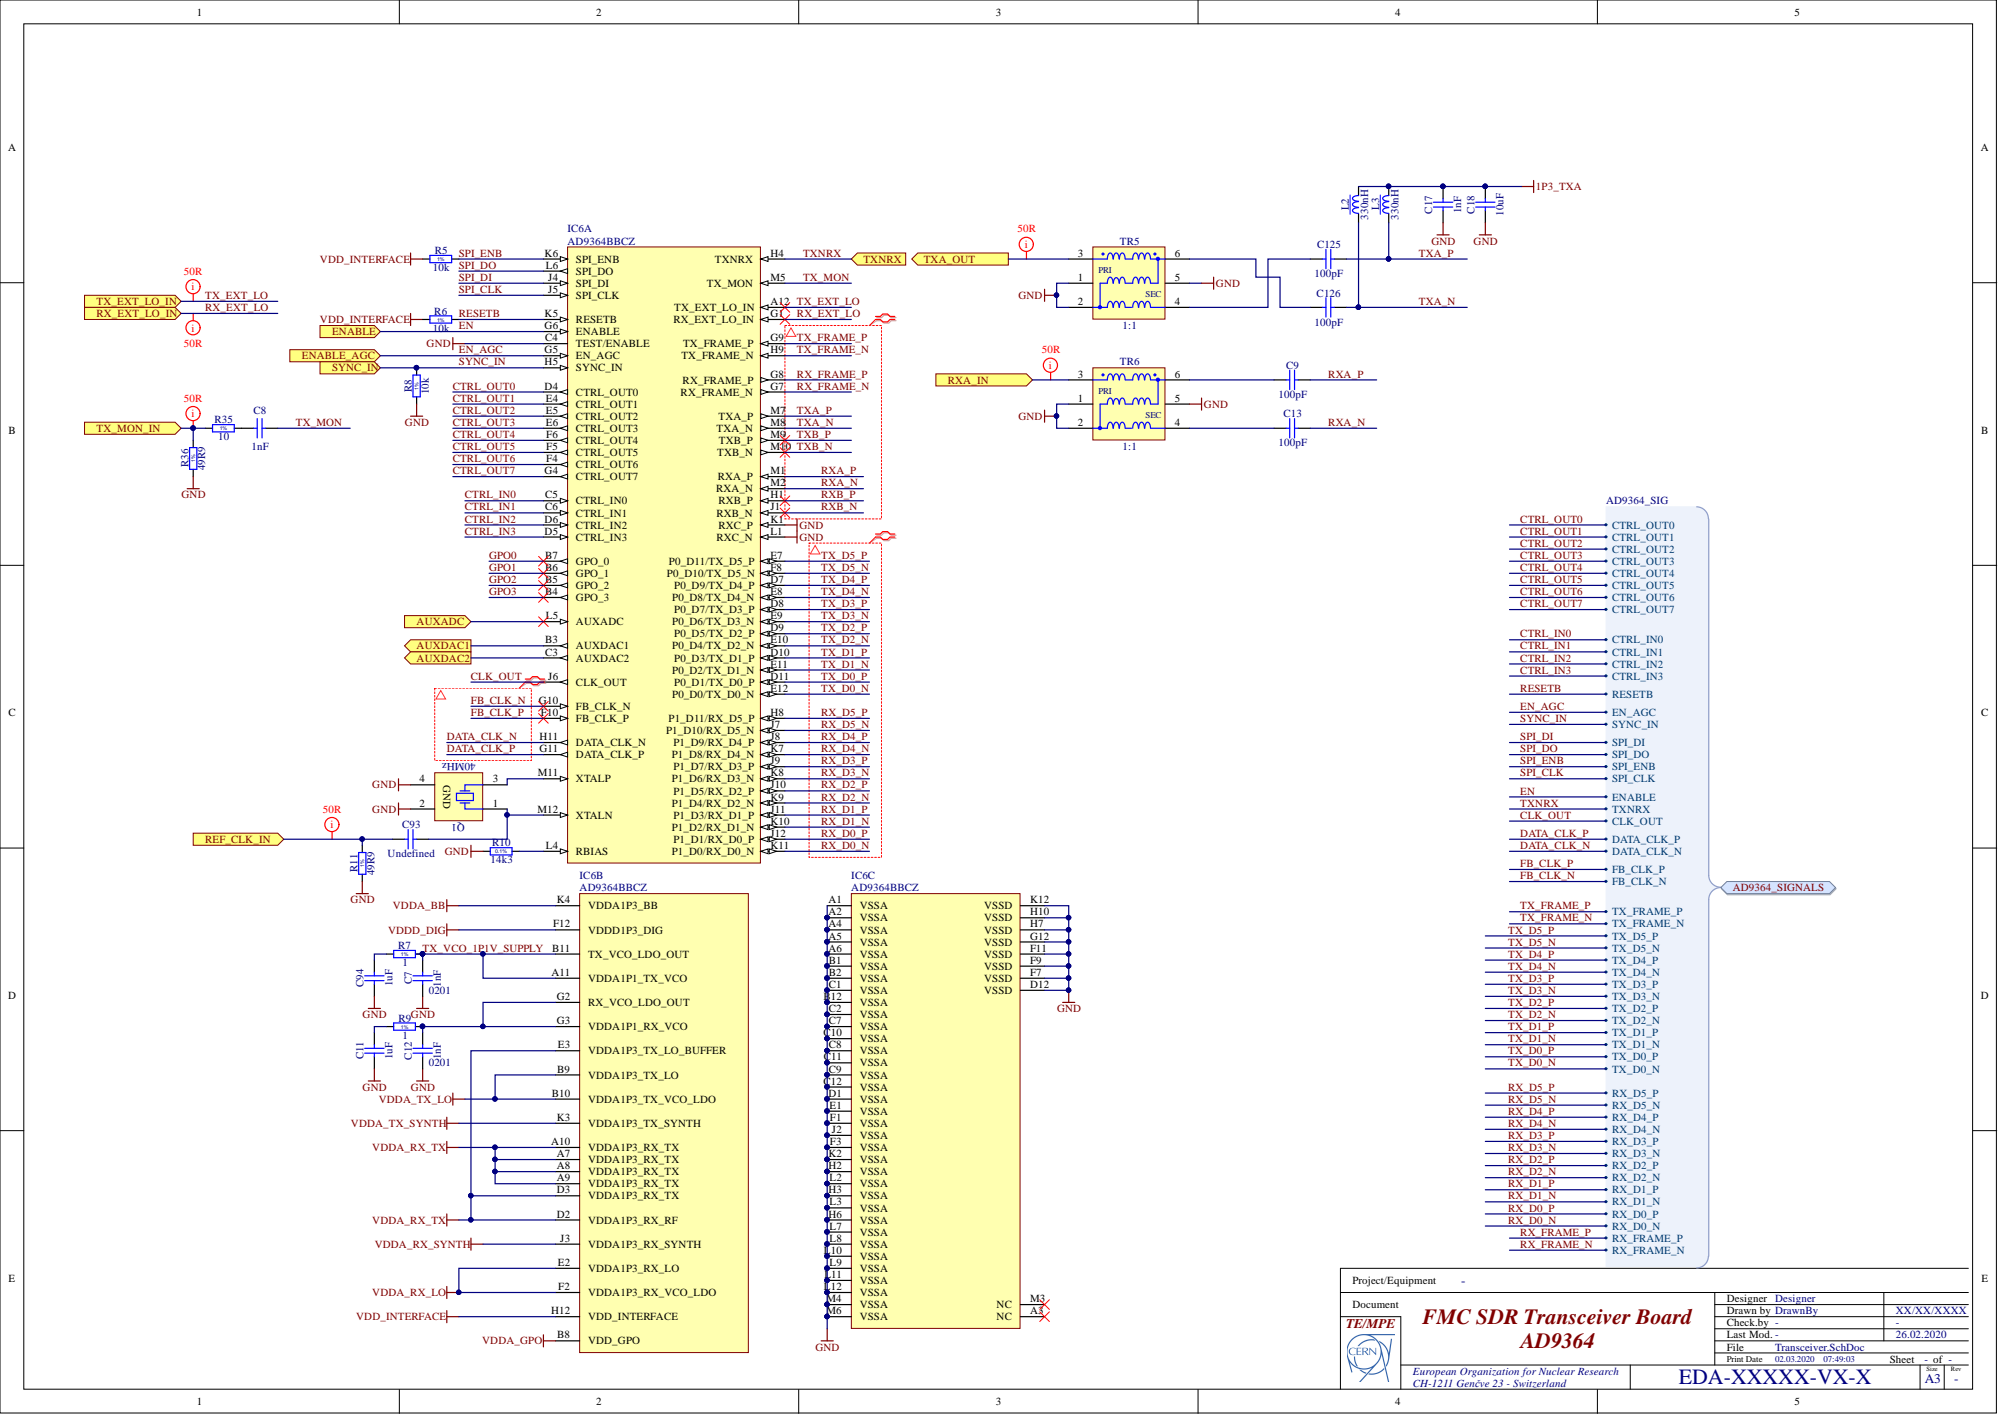
[picture p40: page 6]

1 % | CTRL _ O U T 4 | T XB_ P

A 2 | H 1 0
A 4 | H 7
A 5 | G 1 2
A 6 | 1
