elhep/FMC_SDR/(list of files, drawings)

Other design files:
FMC_SDR/FMC_SDR/FMC_SDR.PrjPcb
FMC_SDR/FMC_SDR/Schematics/fmc_connector.SchDoc
FMC_SDR/FMC_SDR/Schematics/FMC_SDR_top.SchDoc
FMC_SDR/FMC_SDR/Schematics/GroundsCoupling.SchDoc
FMC_SDR/FMC_SDR/Schematics/ipmi.SchDoc
FMC_SDR/FMC_SDR/Schematics/power_supplies.SchDoc
FMC_SDR/FMC_SDR/Schematics/Transceiver.SchDoc
FMC_SDR_LFFE/FMC_SDR_LFFE/CarrierRecovery.SchDoc
FMC_SDR_LFFE/FMC_SDR_LFFE/FMC_SDR_LFFE.PrjPcb
FMC_SDR_LFFE/FMC_SDR_LFFE/FrontEnd.SchDoc
FMC_SDR_LFFE/FMC_SDR_LFFE/FrontEnd_PS.SchDoc
FMC_SDR_LFFE/FMC_SDR_LFFE/LTM8032_3V8.SchDoc
FMC_SDR_LFFE/FMC_SDR_LFFE/LTM8032_5V5.SchDoc
FMC_SDR_LFFE/FMC_SDR_LFFE/LTM8056.SchDoc
FMC_SDR_LFFE/FMC_SDR_LFFE/QPL9065.SchDoc
FMC_SDR_LFFE/FMC_SDR_LFFE/TDDswitches.SchDoc
FMC_SDR_LFFE/FMC_SDR_LFFE/TGA2237orHMC453.SchDoc
FMC_SDR_LFFE/FMC_SDR_LFFE/TXpreamp.SchDoc
FMC_SDR_PCB/PCB-Layout/FMC_SDR.PcbDoc
FMC_SDR_XFE/FMC_SDR_XFE/FMC_SDR_XFE.PrjPcb
FMC_SDR_XFE/FMC_SDR_XFE/FMC_SDR_XFE.SCHLIB
FMC_SDR_XFE/FMC_SDR_XFE/FrontEnd.SchDoc
FMC_SDR_XFE/FMC_SDR_XFE/FrontEnd_PS.SchDoc
FMC_SDR_XFE/FMC_SDR_XFE/GroundsCoupling.SchDoc
FMC_SDR_XFE/FMC_SDR_XFE/LT3080.SchDoc
FMC_SDR_XFE/FMC_SDR_XFE/LTM8056.SchDoc
FMC_SDR_XFE/FMC_SDR_XFE/LTM8074.SchDoc
FMC_SDR_XFE/FMC_SDR_XFE/LTM8074_PA.SchDoc
FMC_SDR_XFE/FMC_SDR_XFE/LTM8074neg.SchDoc
FMC_SDR_XFE/FMC_SDR_XFE/LTM8074neg_PA.SchDoc
FMC_SDR_XFE/FMC_SDR_XFE/PLL.SchDoc
FMC_SDR_XFE/FMC_SDR_XFE/Preamp.SchDoc
FMC_SDR_XFE/FMC_SDR_XFE/PreampTX.SchDoc
FMC_SDR_XFE/FMC_SDR_XFE/QPA2609.SchDoc
FMC_SDR_XFE/FMC_SDR_XFE/TGA3042.SchDoc
