elhep/FMC_SDR/(commit log)

2018-10-14 repo init
    [FMC_SDR.PcbDoc, FMC_SDR.PrjPCB, FMC_SDR_top.SchDoc, fmc_connector.SchDoc, ipmi.SchDoc, power_supplies.SchDoc]
2019-02-06 AD9364 v1 schematics
    [FMC_SDR.PrjPCB, FMC_SDR_top.SchDoc, Transceiver.SchDoc, fmc_connector.SchDoc, ipmi.SchDoc, power_supplies.SchDoc]
2019-11-15 <all in progress> Board splitted into AD9364 part and frontend part, frontend projects and multiboard project created.
    [CarrierRecovery.SchDoc, FMC_SDR.PcbLib, FMC_SDR.PrjPCB, FMC_SDR_LFFE.PrjPcb, FMC_SDR_XFE.PcbLib, FMC_SDR_XFE.PrjPcb, FMC_SDR_XFE.SCHLIB, FMC_SDR_top.SchDoc]
2020-03-03 GK remarks intoduced, ready for next review (#8)
    * in progress
    * kolejna wersja
    * SIGNALS ROUTED
    * While connecting PS
    * GNDs coupling left. No DRC check yet.
    * before adding shielding caps
    * before stiching
    * THE MIDDLE OF NOWWHERE
    * still placing caps
    * before stiching
    * Decoupling placed. DRC not checked. Few signals not routed yet.
    * middle of stackup change
    * TO DO : silk drc, heat reception polygons,
    * almost, 21 DRC left
    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
    [FMC_SDR.PcbLib, FMC_SDR.PrjPCB, FMC_SDR.PrjPcb, FMC_SDR_LFFE.PrjPcb, FMC_SDR_XFE.PrjPcb, FMC_SDR_XFE.SCHLIB, FMC_SDR_top.SchDoc, FrontEnd.SchDoc]
2020-03-03 GK remarks intoduced, ready for next review (#6)
    * fmc caps placed
    * sdr placed and partialy routed
    * Routing nearly done. Moved to new project file FMC_SDR because of problem with strange behaviour, possibly settings which I dont know.
    * 3 signals left to route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
2020-03-03 new files added (#9)
    * 3 signals left to route
    * forgot ipmi
    * multiboar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
2020-03-03 [in progress] merging (#10)
    * mu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
    [Bill of Materials-FMC_SDR.xls, Bill of Materials-FMC_SDR_XFE.xls, FMC_SDR.DWG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]
2020-03-03 [repo cleanup in progress] (#11)
    * forgot ipmi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
2020-03-03 [repo cleanup 2] (#12)
    * multibo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
    [FMC_SDR.PrjPcb, FMC_SDR_XFE.PrjPcb]
2020-03-03 [repo cleanup in progress 3] (#13)
    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
    [FMC_SDR.PcbLib, FMC_SDR.PrjPcb, FMC_SDR_XFE.PcbLib, FMC_SDR_XFE.PrjPcb, TDDswitches.SchDoc]
2020-03-03 cleanup finished, ready for next review (#14)
    * f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
    [FMC_SDR_XFE.PrjPcb, FrontEnd.SchDoc]
2020-03-03 gerber files of xfe added (#15)
    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
    [FMC_SDR_XFE.GBL, FMC_SDR_XFE.GBP, FMC_SDR_XFE.GBS, FMC_SDR_XFE.GM1, FMC_SDR_XFE.GTL, FMC_SDR_XFE.GTP, FMC_SDR_XFE.GTS]
2020-03-18 Differential lines matched (intra-pair=3ps , inter-pair=20ps). Soldermask modified to cover vias. New shield model added to multiboard. (#16)
    * Routing nearly done. Moved to new project file FMC_SDR because of problem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
    [FMC_SDR.GBL, FMC_SDR.GBP, FMC_SDR.GBS, FMC_SDR.GM1, FMC_SDR.GTL, FMC_SDR.GTP, FMC_SDR.GTS, FMC_SDR_XFE.GBL]
